MarcosQOliva/SongBeam/modulesTAD/GJM1555C1H470JB01D/GJM1555C1H470JB01D.step

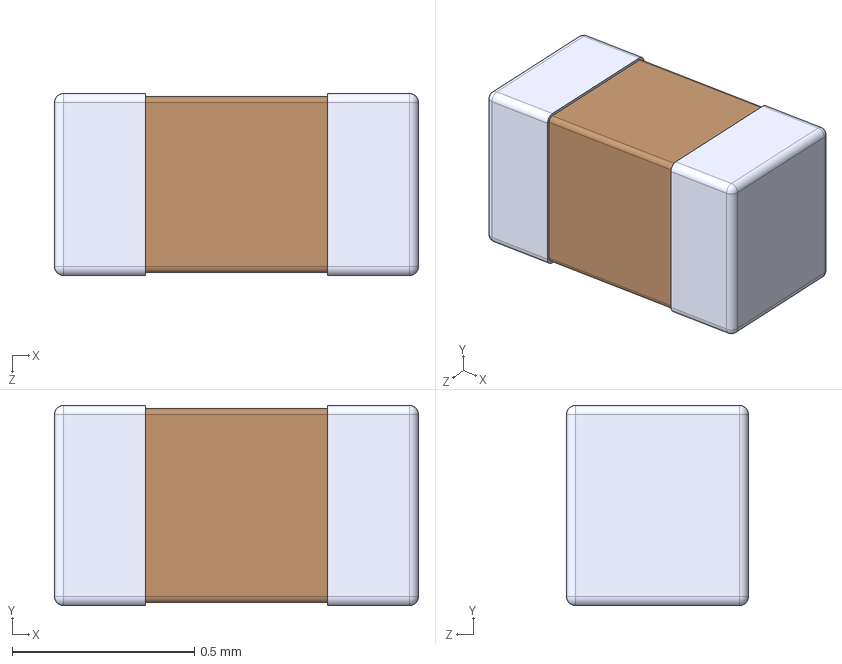
[picture p1: CAD file, 2026-02-26]
modulesTAD/GJM1555C1H470JB01D/GJM1555C1H470JB01D.step
1.00 x 0.55 x 0.5 mm
