MarcosQOliva/SongBeam/modulesTAD/LIB_ADAU7112ACBZR7/ADAU7112ACBZR7.stp

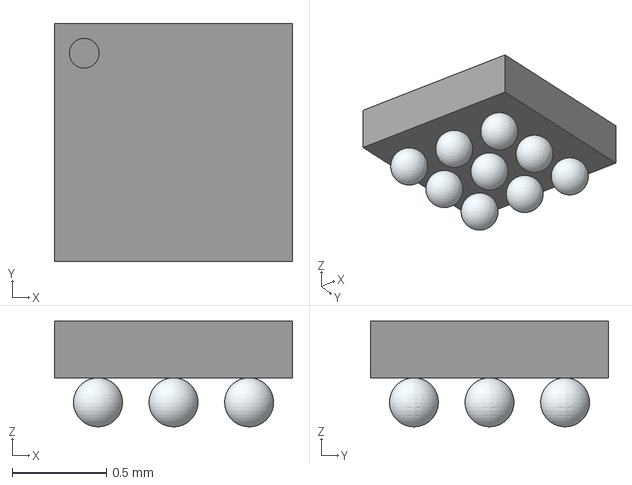
[picture p2: CAD file, 2026-11-06]
modulesTAD/LIB_ADAU7112ACBZR7/ADAU7112ACBZR7.stp
1.26 x 1.26 x 0.56 mm
