MarcosQOliva/SongBeam/modulesTAD/LIB_DTC143ZEBTL/DTC143ZEBTL.stp

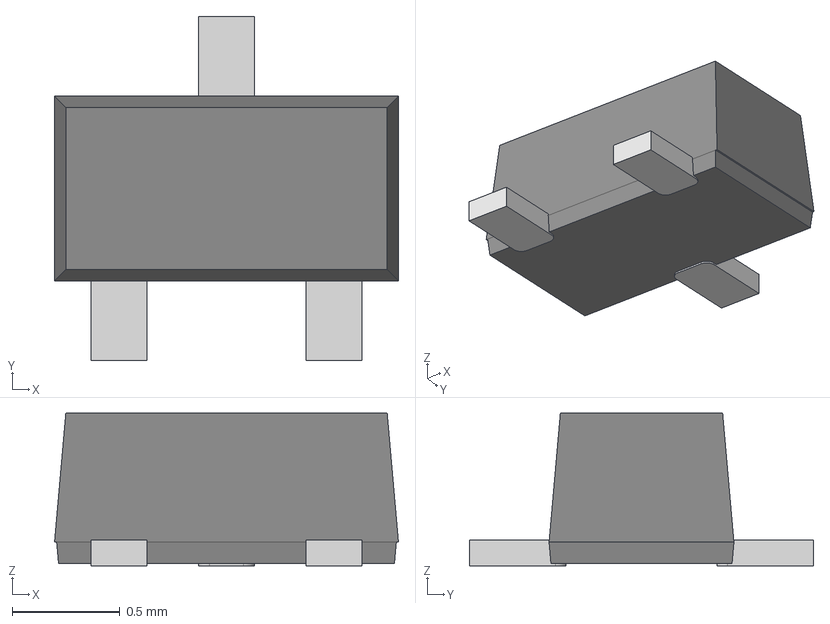
[picture p3: CAD file, 2026-03-02]
modulesTAD/LIB_DTC143ZEBTL/DTC143ZEBTL.stp
1.60 x 1.60 x 0.71 mm
EMT3F-prt0
EMT3F-prt1
EMT3F-prt2
EMT3F-prt3
