MarcosQOliva/SongBeam/modulesTAD/LIB_L86-M33/L86-M33.stp

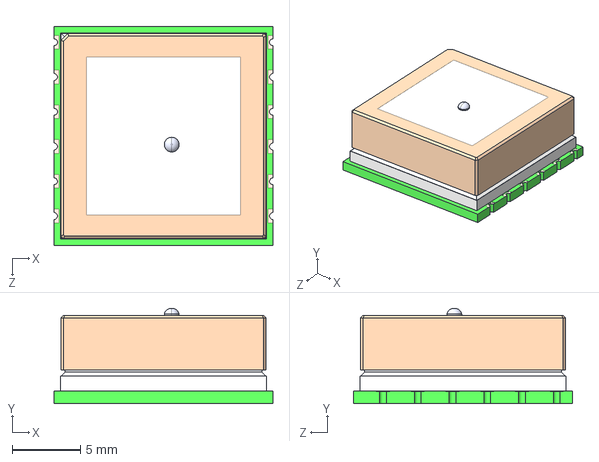
[picture p4: CAD file, 2026-03-02]
modulesTAD/LIB_L86-M33/L86-M33.stp
16.0 x 6.95 x 16.0 mm
