MarcosQOliva/SongBeam/modulesTAD/LIB_MBRX120LF-TP/MBRX120LF-TP.stp

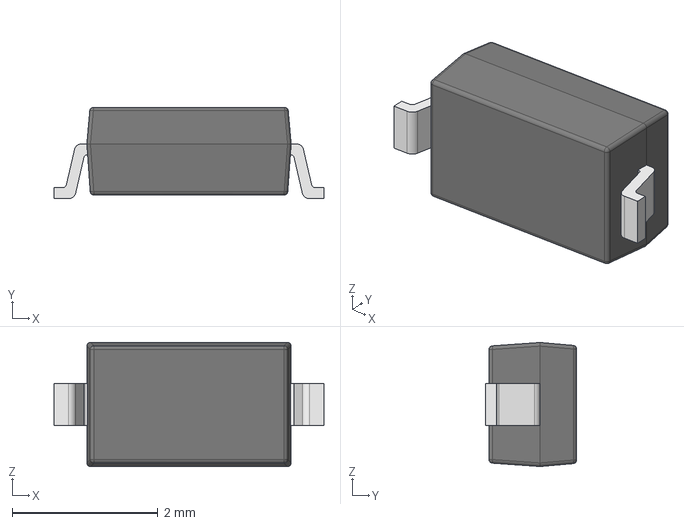
[picture p5: CAD file, 2026-03-02]
modulesTAD/LIB_MBRX120LF-TP/MBRX120LF-TP.stp
3.70 x 1.25 x 1.70 mm
��1
��2
