MarcosQOliva/SongBeam/modulesTAD/LIB_MINISMDC050F-2/MINISMDC050F-2.stp

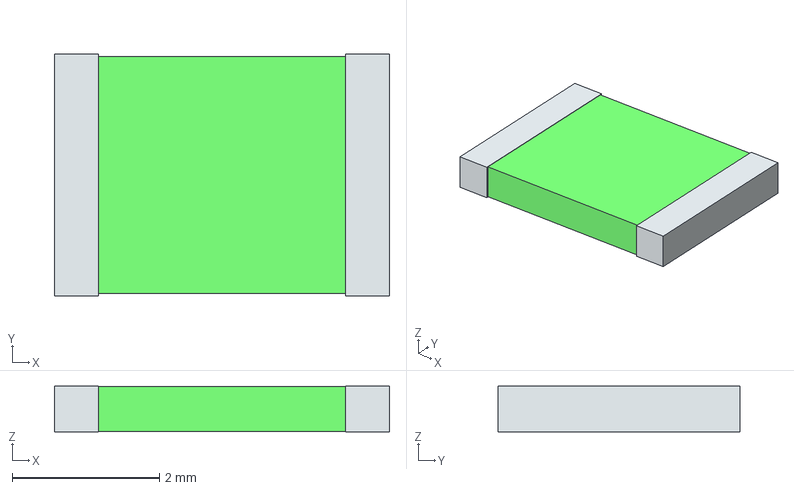
[picture p6: CAD file, 2026-03-02]
modulesTAD/LIB_MINISMDC050F-2/MINISMDC050F-2.stp
4.55 x 3.29 x 0.62 mm
term1
term2
