MarcosQOliva/SongBeam/modulesTAD/LIB_SFH_2716_A01/SFH2716A01.stp

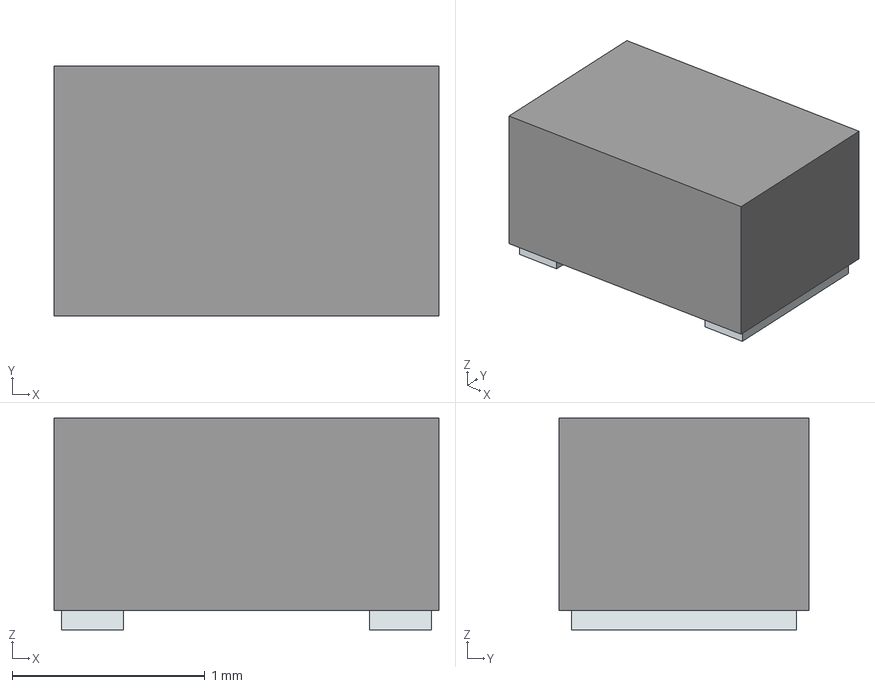
[picture p7: CAD file, 2026-03-02]
modulesTAD/LIB_SFH_2716_A01/SFH2716A01.stp
2.00 x 1.30 x 1.10 mm
Pins
