MarcosQOliva/SongBeam/modulesTAD/LIB_SLW-12689-4A-N-D/SLW-12689-4A-N-D.stp

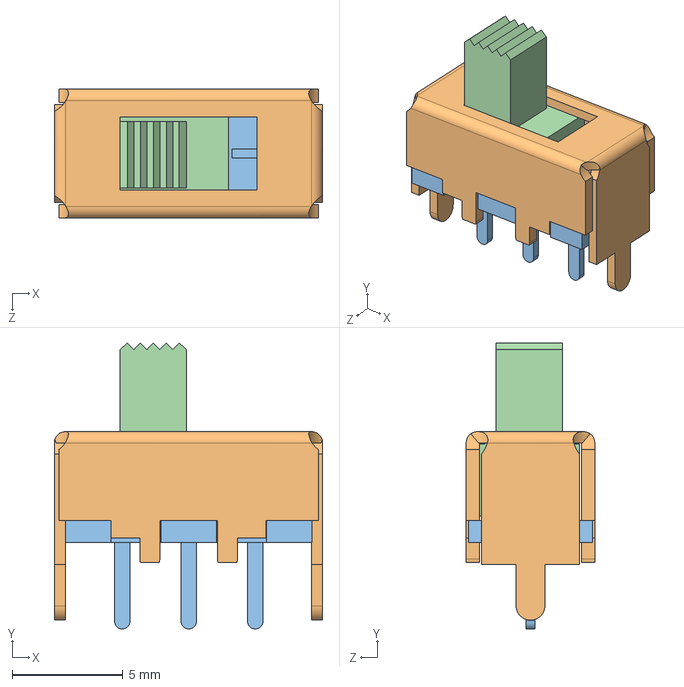
[picture p8: CAD file, 2026-03-02]
modulesTAD/LIB_SLW-12689-4A-N-D/SLW-12689-4A-N-D.stp
12.1 x 12.9 x 5.80 mm
