MarcosQOliva/SongBeam/modulesTAD/LIB_TXU0304RUTR/TXU0304RUTR.stp

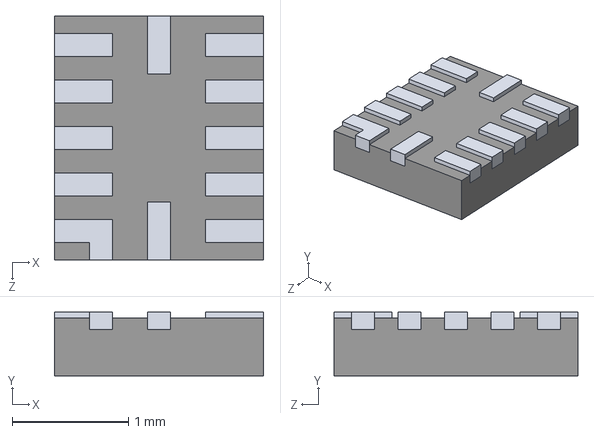
[picture p9: CAD file, 2026-11-06]
modulesTAD/LIB_TXU0304RUTR/TXU0304RUTR.stp
1.80 x 0.55 x 2.10 mm
