MarcosQOliva/SongBeam/modulesTAD/ul_PCMD3180IRTWR/PCMD3180IRTWT.stp

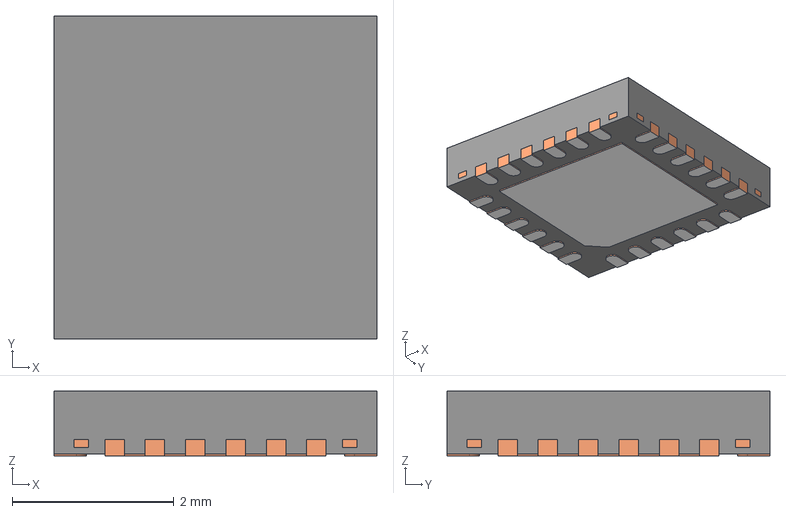
[picture p10: CAD file, 2026-03-02]
modulesTAD/ul_PCMD3180IRTWR/PCMD3180IRTWT.stp
4.00 x 4.00 x 0.8 mm
BODY-QFN
FRAME-RTW0024H
PIN1-ID
