MarcosQOliva/SongBeam/modulesTAD/ul_TPL5111DDCR/TPL5111DDCR.stp

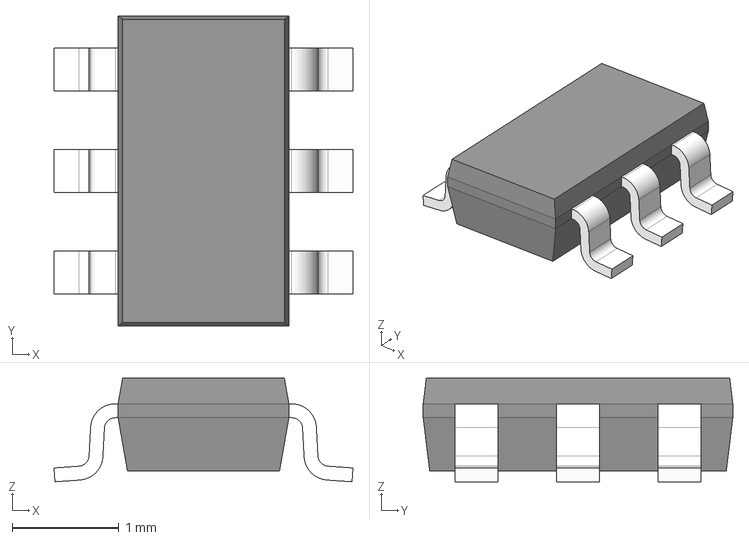
[picture p11: CAD file, 2026-03-02]
modulesTAD/ul_TPL5111DDCR/TPL5111DDCR.stp
2.80 x 2.90 x 0.97 mm
BODY-SOT
LEAD-SOT x 6
