MarcosQOliva/SongBeam/modulesTAD/CONN_73251-1150_MOL/73251-1150.stp

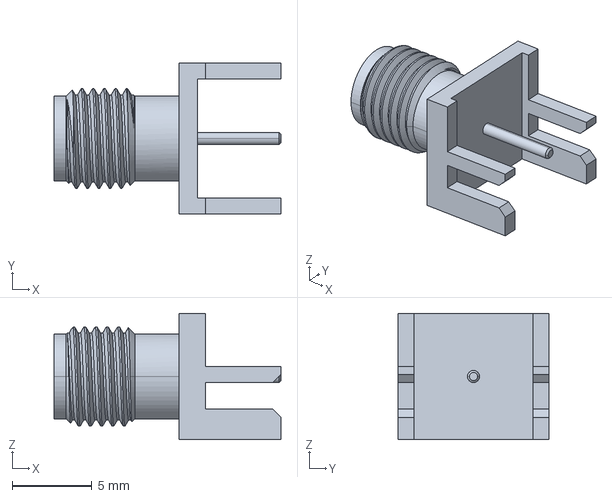
[picture p12: CAD file, 2026-03-02]
modulesTAD/CONN_73251-1150_MOL/73251-1150.stp
14.3 x 9.53 x 7.92 mm
