MarcosQOliva/SongBeam/modulesTAD/LIB_10118192-0002LF/10118192-0002LF.stp

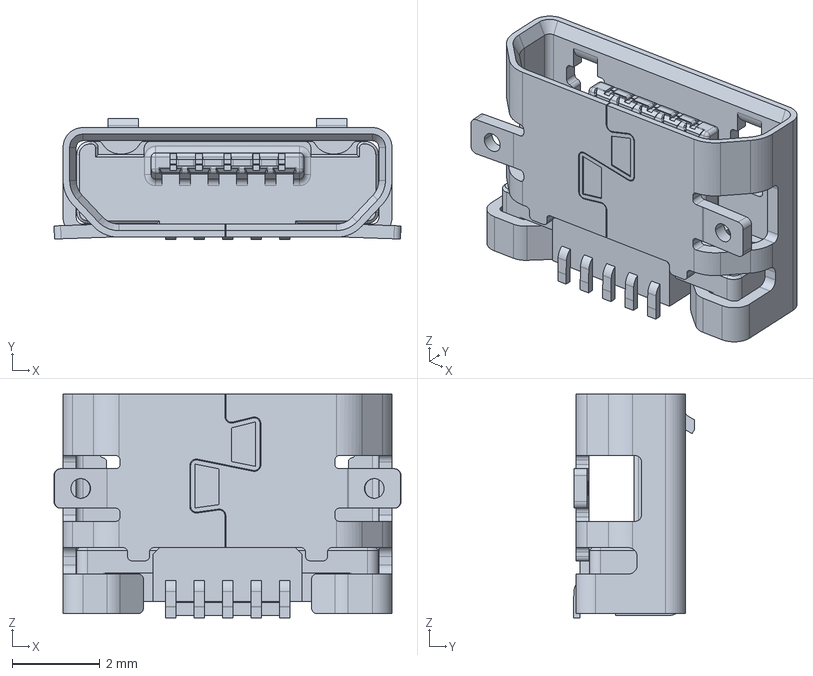
[picture p13: CAD file, 2026-03-02]
modulesTAD/LIB_10118192-0002LF/10118192-0002LF.stp
7.91 x 2.77 x 5.10 mm
