MarcosQOliva/SongBeam/modulesTAD/LIB_79523211/79523211.stp

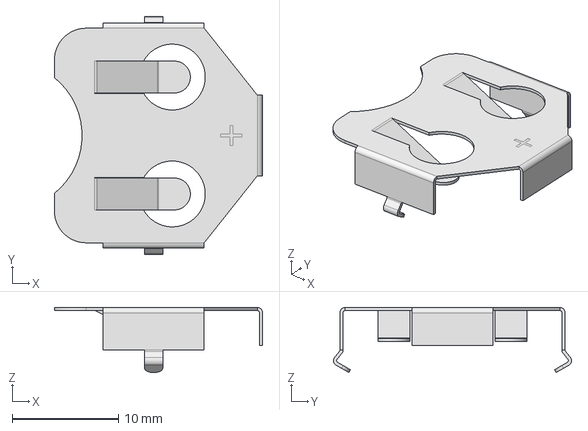
[picture p14: CAD file, 2026-03-02]
modulesTAD/LIB_79523211/79523211.stp
19.6 x 22.4 x 6.12 mm
