MarcosQOliva/SongBeam/modulesTAD/LIB_DFE201612E-2R2M=P2/DFE201612E-2R2M=P2.stp

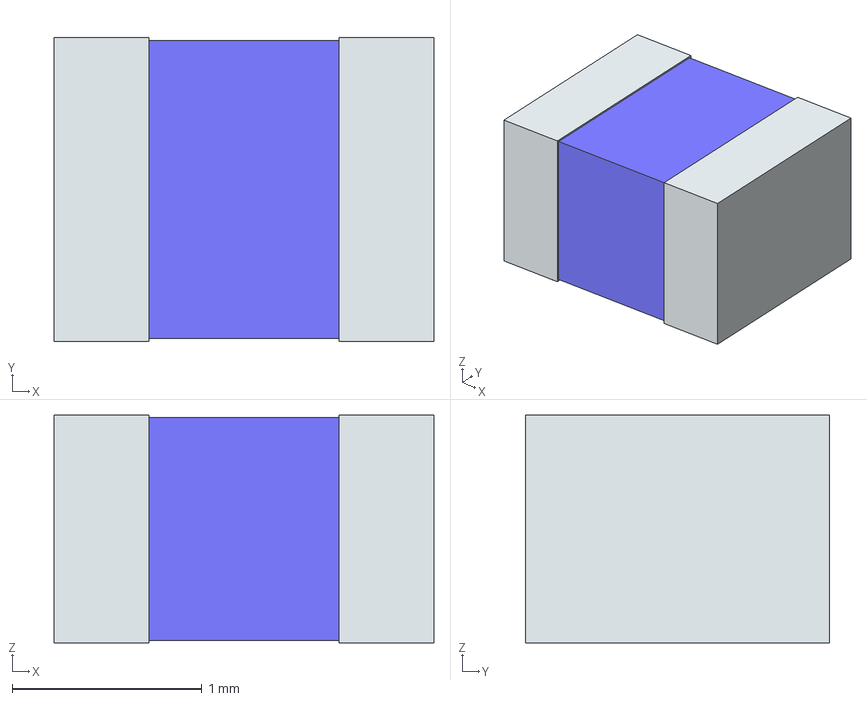
[picture p15: CAD file, 2026-03-02]
modulesTAD/LIB_DFE201612E-2R2M=P2/DFE201612E-2R2M=P2.stp
2.00 x 1.60 x 1.20 mm
term1
term2
