MarcosQOliva/SongBeam/Hardware/MIcBoard_1/plots/MIcBoard_1__Assembly.pdf

AB

AB

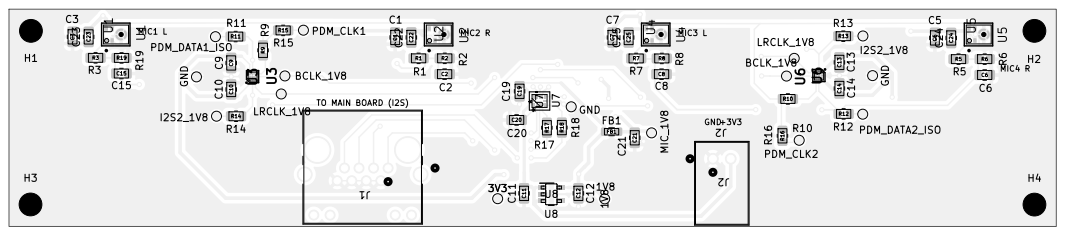
[picture p16: page 1]

Board2Pdf: Black And White TOP - Page 1/2

Marcos Q. Oliva, Rob Lachlan
Royal Holloway
Sheet: Black And White TOP
File: MIcBoard_1.kicad_pcb
Title: SongBeam_micboard
KiCad E.D.A. 10.0.7

AB

AB

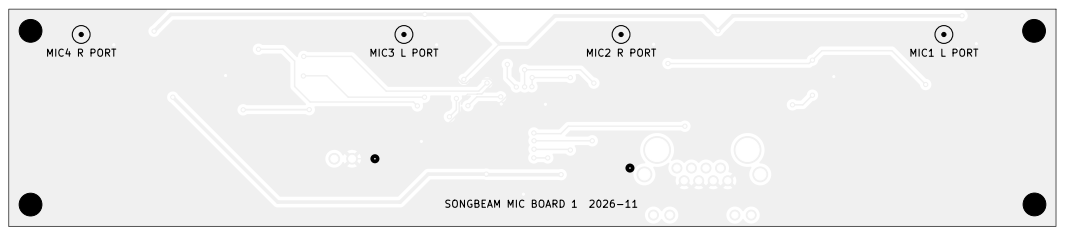
[picture p17: page 2]
MIC2 R PORT; MIC1 L PORT SONGBEAM MIC BOARD 1 2026-11 MIC4 R PORT; MIC3 L PORT 1; D Date: 2026-11-11; Size: A4; Rev: 1.o

Board2Pdf: Black And White BOT - Page 2/2

Marcos Q. Oliva, Rob Lachlan
Royal Holloway
Sheet: Black And White BOT
File: MIcBoard_1.kicad_pcb
Title: SongBeam_micboard
KiCad E.D.A. 10.0.7
