MarcosQOliva/SongBeam/(list of files, drawings)

Other design files:
Hardware/MIcBoard_1/temp-freerouting.dsn
