MarcosQOliva/SongBeam/Hardware/MIcBoard_1/MIcBoard_1.kicad_pcb

## KiCad design Hardware/MIcBoard_1/MIcBoard_1.kicad_pcb (2026-11-11)

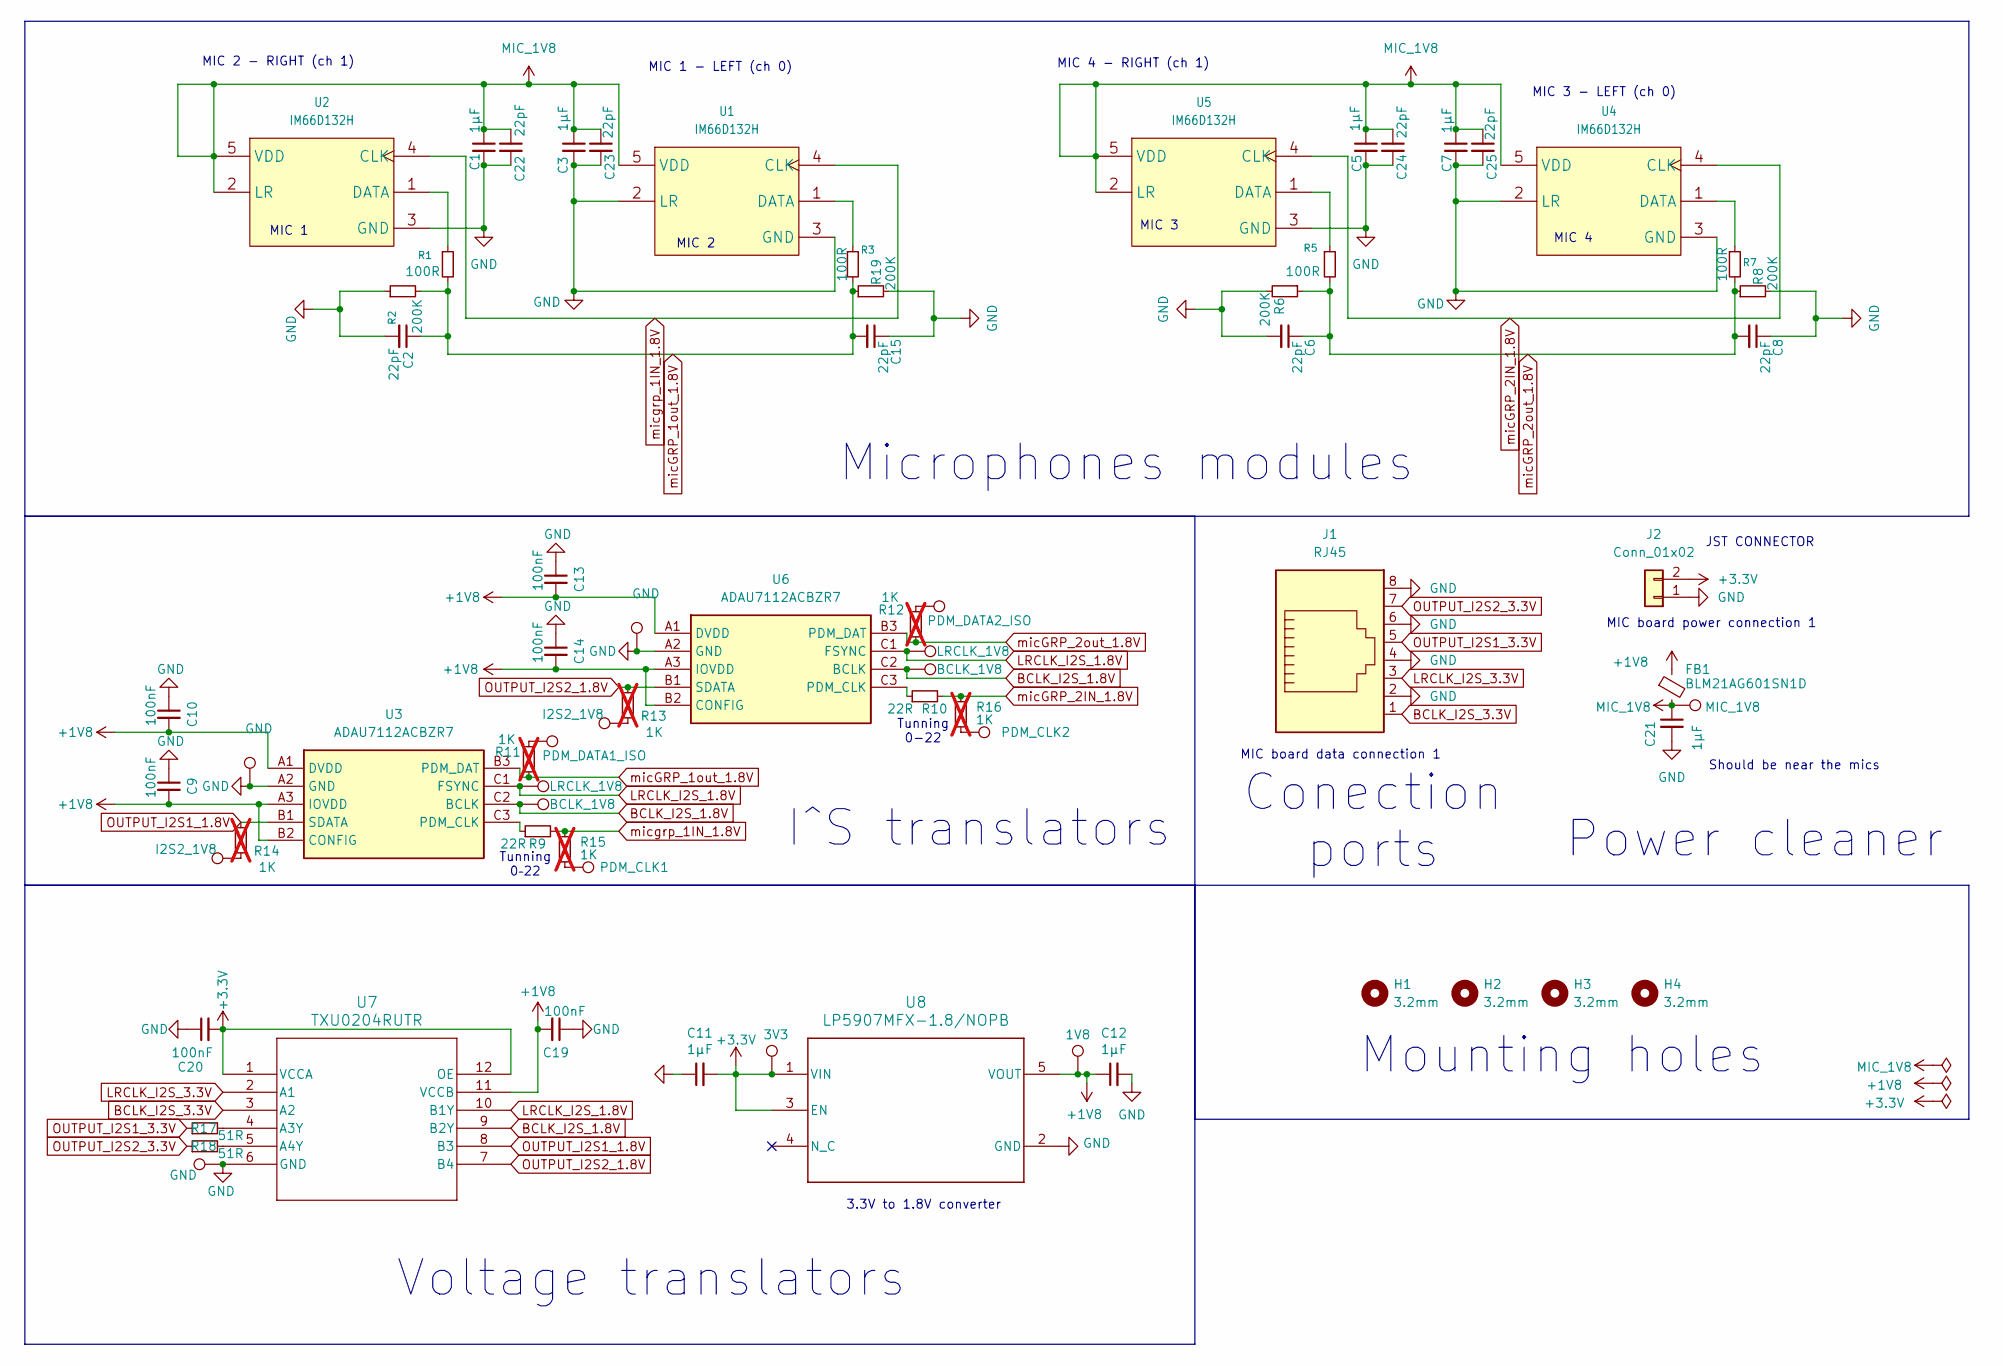
[picture p18: schematic MIcBoard_1.kicad_sch, SongBeam MicB]

Parts:
1V8, 3V3: TestPoint; TestPoint_Pad_D1.0mm
C1, C3, C5, C7, C11, C12, C21: 1µF; C_0805_2012Metric; Voltage 25V
C2, C6, C8, C15, C22, C23, C24, C25: 22pF; C_0805_2012Metric; Voltage 50V
C9, C10, C13, C14, C19, C20: 100nF; C_0805_2012Metric; Voltage 25V
FB1: BLM21AG601SN1D; L_0805_2012Metric
H1, H2, H3, H4: 3.2mm; MountingHole_3.2mm_M3_ISO14580
J1: RJ45; RJHSE5380_AMP
J2: Conn_01x02; CONN_S2B-XH-A_JST
R1, R3, R5, R7: 100R; R_0805_2012Metric
R2, R6, R8, R19: 200K; R_0805_2012Metric
R9, R10: 22R; R_0805_2012Metric
R11, R12, R13, R14, R15, R16: 1K; R_0805_2012Metric; not fitted
R17, R18: 51R; R_0805_2012Metric
TP3: PDM_DATA1_ISO; TestPoint_Pad_D1.0mm
TP4: PDM_DATA2_ISO; TestPoint_Pad_D1.0mm
TP5: MIC_1V8; TestPoint_Pad_D1.0mm
TP6, TP7, TP15: GND; TestPoint_Pad_D1.0mm
TP12, TP19: BCLK_1V8; TestPoint_Pad_D1.0mm
TP13, TP18: LRCLK_1V8; TestPoint_Pad_D1.0mm
TP16: PDM_CLK1; TestPoint_Pad_D1.0mm
TP17, TP21: I2S2_1V8; TestPoint_Pad_D1.0mm
TP20: PDM_CLK2; TestPoint_Pad_D1.0mm
U1, U2, U4, U5: IM66D132H; IFX-PG-TLGA-5N-9-V
U3, U6: ADAU7112ACBZR7; BGA9C40P3X3_126X126X56; Manufacturer_Part_Number ADAU7112ACBZR7; Mouser Part Number 584-AU7112ACBZR7
U7: TXU0204RUTR; QFN_04RUTR_TEX
U8: LP5907MFX-1.8/NOPB; DBV0005A_N

Connections:
+1V8: 1V8.1 (1_1), C9.2, C10.2, C12.1, C13.2, C14.2, C19.2, FB1.1, U3.A1 (DVDD), U3.A3 (IOVDD), U3.B2 (CONFIG), U6.A1 (DVDD), U6.A3 (IOVDD), U6.B2 (CONFIG), U7.11 (VCCB), U8.5 (VOUT)
+3.3V: 3V3.1 (1_1), C11.2, C20.2, J2.2, U7.1 (VCCA), U7.12 (OE), U8.1 (VIN), U8.3 (EN)
BCLK_I2S_1.8V: TP12.1 (1_1), TP19.1 (1_1), U3.C2 (BCLK), U6.C2 (BCLK), U7.9 (B2Y)
BCLK_I2S_3.3V: J1.1, U7.3 (A2)
GND: C1.2, C2.2, C3.2, C5.2, C6.2, C7.2, C8.1, C9.1, C10.1, C11.1, C12.2, C13.1, C14.1, C15.1, C19.1, C20.1, C21.2, C22.2, C23.2, C24.2, C25.2, J1.2, J1.4, J1.6, J1.8, J2.1, R2.1, R6.2, R8.2, R19.2, TP6.1 (1_1), TP7.1 (1_1), TP15.1 (1_1), U1.2 (LR), U1.3 (GND), U2.3 (GND), U3.A2 (GND), U4.2 (LR), U4.3 (GND), U5.3 (GND), U6.A2 (GND), U7.6 (GND), U8.2 (GND)
LRCLK_I2S_1.8V: TP13.1 (1_1), TP18.1 (1_1), U3.C1 (FSYNC), U6.C1 (FSYNC), U7.10 (B1Y)
LRCLK_I2S_3.3V: J1.3, U7.2 (A1)
MIC_1V8: C1.1, C3.1, C5.1, C7.1, C21.1, C22.1, C23.1, C24.1, C25.1, FB1.2, TP5.1 (1_1), U1.5 (VDD), U2.2 (LR), U2.5 (VDD), U4.5 (VDD), U5.2 (LR), U5.5 (VDD)
unnamed: R11.2, TP3.1 (1_1)
unnamed: R12.2, TP4.1 (1_1)
unnamed: R13.1, TP17.1 (1_1)
unnamed: R14.1, TP21.1 (1_1)
unnamed: R15.2, TP16.1 (1_1)
unnamed: R16.2, TP20.1 (1_1)
unnamed: R3.1, U1.1 (DATA)
unnamed: R1.1, U2.1 (DATA)
unnamed: R9.1, U3.C3 (PDM_CLK)
unnamed: R7.1, U4.1 (DATA)
unnamed: R5.1, U5.1 (DATA)
unnamed: R10.1, U6.C3 (PDM_CLK)
unnamed: R17.2, U7.4 (A3Y)
unnamed: R18.2, U7.5 (A4Y)
OUTPUT_I2S1_1.8V: R14.2, U3.B1 (SDATA), U7.8 (B3)
OUTPUT_I2S1_3.3V: J1.5, R17.1
OUTPUT_I2S2_1.8V: R13.2, U6.B1 (SDATA), U7.7 (B4)
OUTPUT_I2S2_3.3V: J1.7, R18.1
micGRP_1out_1.8V: C2.1, C15.2, R1.2, R2.2, R3.2, R11.1, R19.1, U3.B3 (PDM_DAT)
micGRP_2IN_1.8V: R10.2, R16.1, U4.4 (CLK), U5.4 (CLK)
micGRP_2out_1.8V: C6.1, C8.2, R5.2, R6.1, R7.2, R8.1, R12.1, U6.B3 (PDM_DAT)
micgrp_1IN_1.8V: R9.2, R15.1, U1.4 (CLK), U2.4 (CLK)

Notes on the sheet:
Microphones modules
MIC 1 - LEFT (ch 0)
Should be near the mics
Voltage translators
Power cleaner
JST CONNECTOR
MIC 4 - RIGHT (ch 1)
MIC 1
MIC 2
Tunning 0-22
Tunning 0–22
MIC 3
3.3V to 1.8V converter
MIC 4
Conection ports
Mounting holes
MIC 2 - RIGHT (ch 1)
MIC board data connection 1
I^S translators
MIC board power connection 1
MIC 3 - LEFT (ch 0)

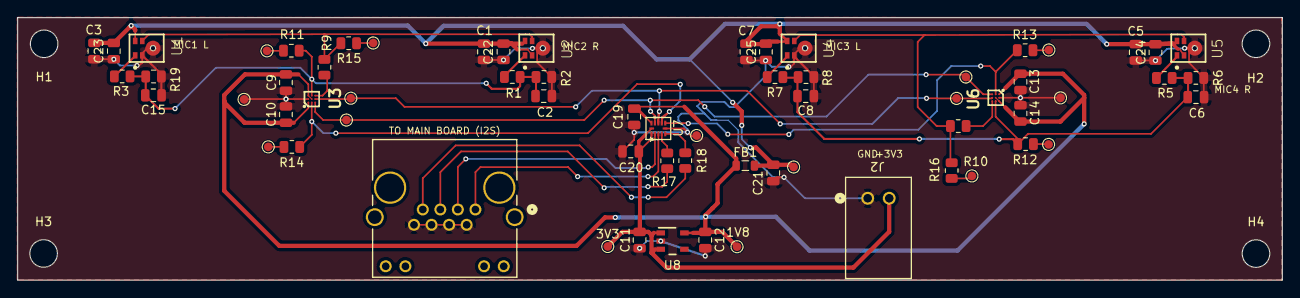
[picture p19: board MIcBoard_1.kicad_pcb from above]

Board: 2 copper layers, 147.0 x 30.5 mm, 70 parts (0 on the bottom side), 30 nets.
