MarcosQOliva/SongBeam/Hardware/Daughterboard_A/daugtherboard_1.2.kicad_pcb

## KiCad design Hardware/Daughterboard_A/daugtherboard_1.2.kicad_pcb (2026-04-28)

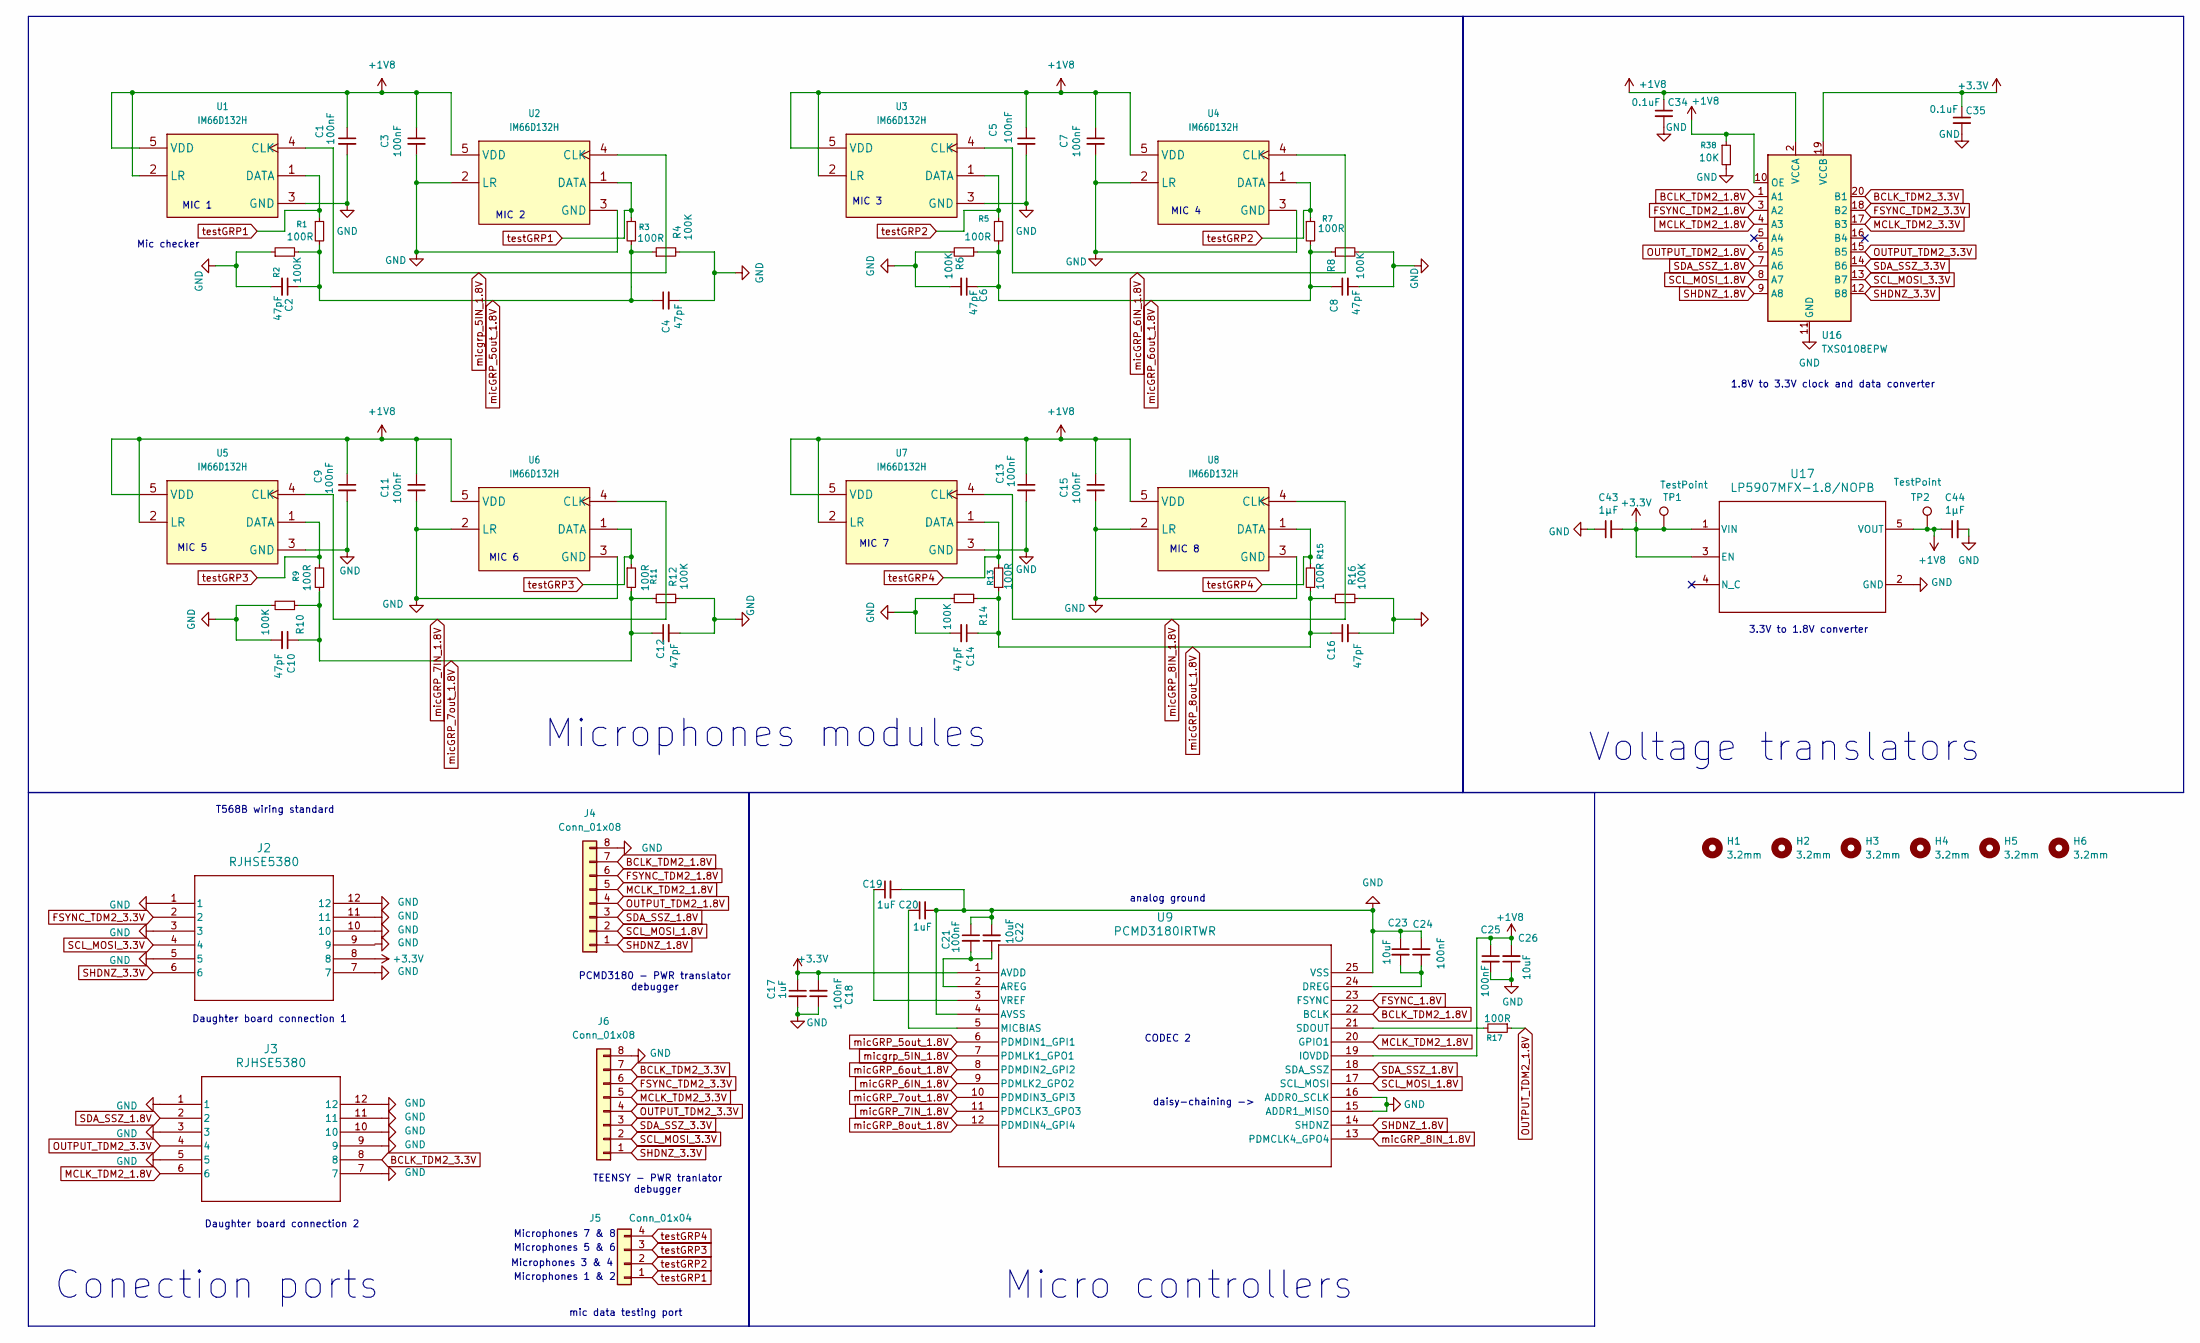
[picture p20: schematic daugtherboard_1.2.kicad_sch, Song beam DaughterBoard A]

Parts:
C1, C3, C5, C7, C9, C11, C13, C15, C18, C21, C24, C25: 100nF; C_0805_2012Metric
C2, C4, C6, C8, C10, C12, C14, C16: 47pF; C_0805_2012Metric
C17, C19, C20: 1uF; C_0805_2012Metric
C22, C23, C26: 10uF; C_0805_2012Metric
C34, C35: 0.1uF; C_0805_2012Metric
C43, C44: 1µF; C_0805_2012Metric
H1, H2, H3, H4, H5, H6: 3.2mm; MountingHole_3.2mm_M3_ISO14580
J2, J3: RJHSE5380; RJHSE5380_AMP
J4, J6: Conn_01x08; PinHeader_1x08_P2.00mm_Vertical
J5: Conn_01x04; PinHeader_1x04_P2.00mm_Vertical
R1, R3, R5, R7, R9, R11, R13, R15, R17: 100R; R_0805_2012Metric
R2, R4, R6, R8, R10, R12, R14, R16: 100K; R_0805_2012Metric
R38: 10K; R_0805_2012Metric
TP1, TP2: TestPoint; TestPoint_Pad_D1.0mm
U1, U2, U3, U4, U5, U6, U7, U8: IM66D132H; IFX-PG-TLGA-5N-9-V
U9: PCMD3180IRTWR
U16: TXS0108EPW; TSSOP-20_4.4x6.5mm_P0.65mm
U17: LP5907MFX-1.8/NOPB; DBV0005A_N

Connections:
+1V8: C1.1, C3.1, C5.1, C7.1, C9.1, C11.1, C13.1, C15.1, C25.1, C26.2, C34.1, C44.1, R38.1, TP2.1, U1.2 (LR), U1.5 (VDD), U2.5 (VDD), U3.2 (LR), U3.5 (VDD), U4.5 (VDD), U5.2 (LR), U5.5 (VDD), U6.5 (VDD), U7.2 (LR), U7.5 (VDD), U8.5 (VDD), U9.19 (IOVDD), U16.2 (VCCA), U16.10 (OE), U17.5 (VOUT)
+3.3V: C17.1, C18.2, C35.1, C43.2, J2.8, TP1.1, U9.1 (AVDD), U16.19 (VCCB), U17.1 (VIN), U17.3 (EN)
BCLK_TDM2_1.8V: J4.7, U9.22 (BCLK), U16.1 (A1)
BCLK_TDM2_3.3V: J3.8, J6.7, U16.20 (B1)
FSYNC_1.8V: U9.23 (FSYNC)
FSYNC_TDM2_1.8V: J4.6, U16.3 (A2)
FSYNC_TDM2_3.3V: J2.2, J6.6, U16.18 (B2)
GND: C1.2, C2.2, C3.2, C4.2, C5.2, C6.2, C7.2, C8.2, C9.2, C10.2, C11.2, C12.2, C13.2, C14.2, C15.2, C16.2, C17.2, C18.1, C19.2, C20.2, C21.1, C22.2, C23.1, C24.2, C25.2, C26.1, C34.2, C35.2, C43.1, C44.2, J2.1, J2.3, J2.5, J2.7, J2.10, J2.11, J2.12, J3.1, J3.3, J3.5, J3.7, J3.9, J3.10, J3.11, J3.12, J4.8, J6.8, R2.1, R4.2, R6.2, R8.2, R10.2, R12.2, R14.2, R16.2, R38.2, U1.3 (GND), U2.2 (LR), U2.3 (GND), U3.3 (GND), U4.2 (LR), U4.3 (GND), U5.3 (GND), U6.2 (LR), U6.3 (GND), U7.3 (GND), U8.2 (LR), U8.3 (GND), U9.4 (AVSS), U9.15 (ADDR1_MISO), U9.16 (ADDR0_SCLK), U9.25 (VSS), U16.11 (GND), U17.2 (GND)
MCLK_TDM2_1.8V: J3.6, J4.5, U9.20 (GPIO1), U16.4 (A3)
MCLK_TDM2_3.3V: J6.5, U16.17 (B3)
unnamed: C21.2, C22.1, U9.2 (AREG)
unnamed: C23.2, C24.1, U9.24 (DREG)
unnamed: C20.1, U9.5 (MICBIAS)
unnamed: R17.2, U9.21 (SDOUT)
unnamed: C19.1, U9.3 (VREF)
OUTPUT_TDM2_1.8V: J4.4, R17.1, U16.6 (A5)
OUTPUT_TDM2_3.3V: J3.4, J6.4, U16.15 (B5)
SCL_MOSI_1.8V: J4.2, U9.17 (SCL_MOSI), U16.8 (A7)
SCL_MOSI_3.3V: J2.4, J6.2, U16.13 (B7)
SDA_SSZ_1.8V: J3.2, J4.3, U9.18 (SDA_SSZ), U16.7 (A6)
SDA_SSZ_3.3V: J6.3, U16.14 (B6)
SHDNZ_1.8V: J4.1, U9.14 (SHDNZ), U16.9 (A8)
SHDNZ_3.3V: J2.6, J6.1, U16.12 (B8)
micGRP_5out_1.8V: C2.1, C4.1, R1.2, R2.2, R3.2, R4.1, U9.6 (PDMDIN1_GPI1)
micGRP_6IN_1.8V: U3.4 (CLK), U4.4 (CLK), U9.9 (PDMLK2_GPO2)
micGRP_6out_1.8V: C6.1, C8.1, R5.2, R6.1, R7.2, R8.1, U9.8 (PDMDIN2_GPI2)
micGRP_7IN_1.8V: U5.4 (CLK), U6.4 (CLK), U9.11 (PDMCLK3_GPO3)
micGRP_7out_1.8V: C10.1, C12.1, R9.2, R10.1, R11.2, R12.1, U9.10 (PDMDIN3_GPI3)
micGRP_8IN_1.8V: U7.4 (CLK), U8.4 (CLK), U9.13 (PDMCLK4_GPO4)
micGRP_8out_1.8V: C14.1, C16.1, R13.1, R14.1, R15.1, R16.1, U9.12 (PDMDIN4_GPI4)
micgrp_5IN_1.8V: U1.4 (CLK), U2.4 (CLK), U9.7 (PDMLK1_GPO1)
testGRP1: J5.1, R1.1, R3.1, U1.1 (DATA), U2.1 (DATA)
testGRP2: J5.2, R5.1, R7.1, U3.1 (DATA), U4.1 (DATA)
testGRP3: J5.3, R9.1, R11.1, U5.1 (DATA), U6.1 (DATA)
testGRP4: J5.4, R13.2, R15.2, U7.1 (DATA), U8.1 (DATA)

Notes on the sheet:
Mic checker
MIC 7
TEENSY - PWR tranlator debugger
MIC 1
3.3V to 1.8V converter
Microphones 3 & 4
analog ground
MIC 5
Voltage translators
MIC 8
Daughter board connection 1
CODEC 2
PCMD3180 - PWR translator debugger
Microphones modules
MIC 6
Microphones 7 & 8
1.8V to 3.3V clock and data converter
Daughter board connection 2
Micro controllers
Microphones 1 & 2
daisy-chaining ->
T568B wiring standard
Microphones 5 & 6
MIC 2
MIC 4
Conection ports
MIC 3
mic data testing port

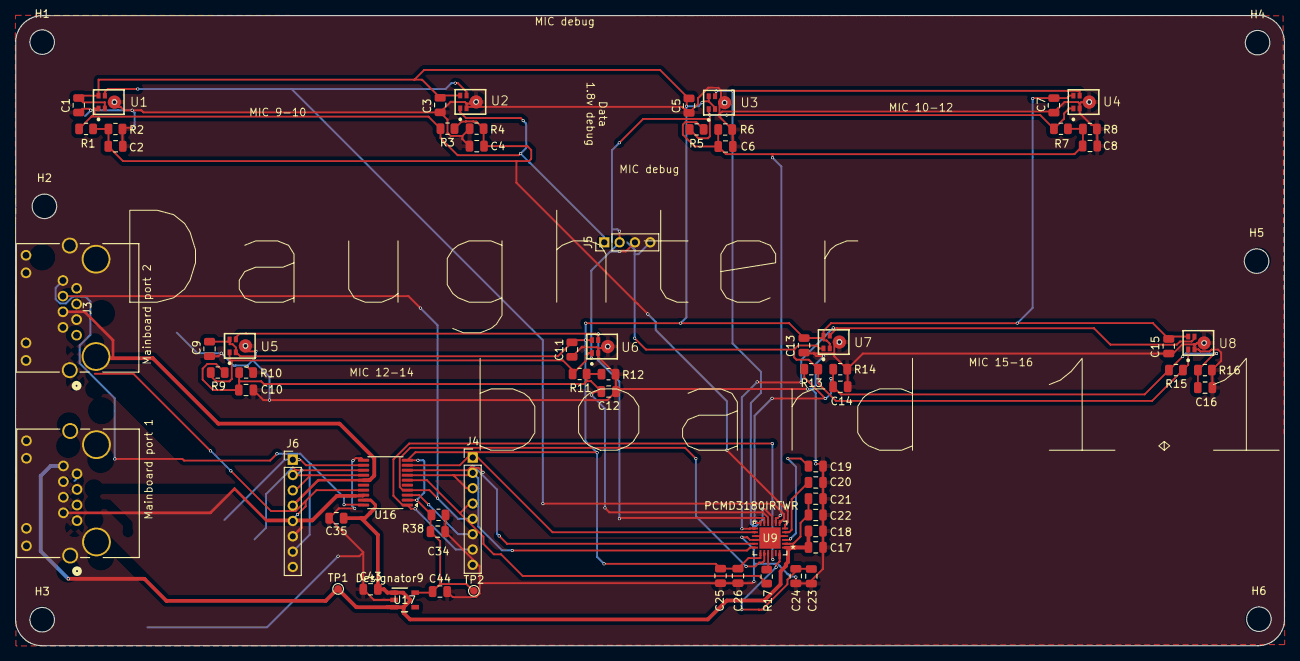
[picture p21: board daugtherboard_1.2.kicad_pcb from above]

Board: 2 copper layers, 165.6 x 82.3 mm, 72 parts (0 on the bottom side), 34 nets.
