MarcosQOliva/SongBeam/Hardware/SongBeam4.0/SongBeam4.1.kicad_pcb

## KiCad design Hardware/SongBeam4.0/SongBeam4.1.kicad_pcb (2026-03-04)

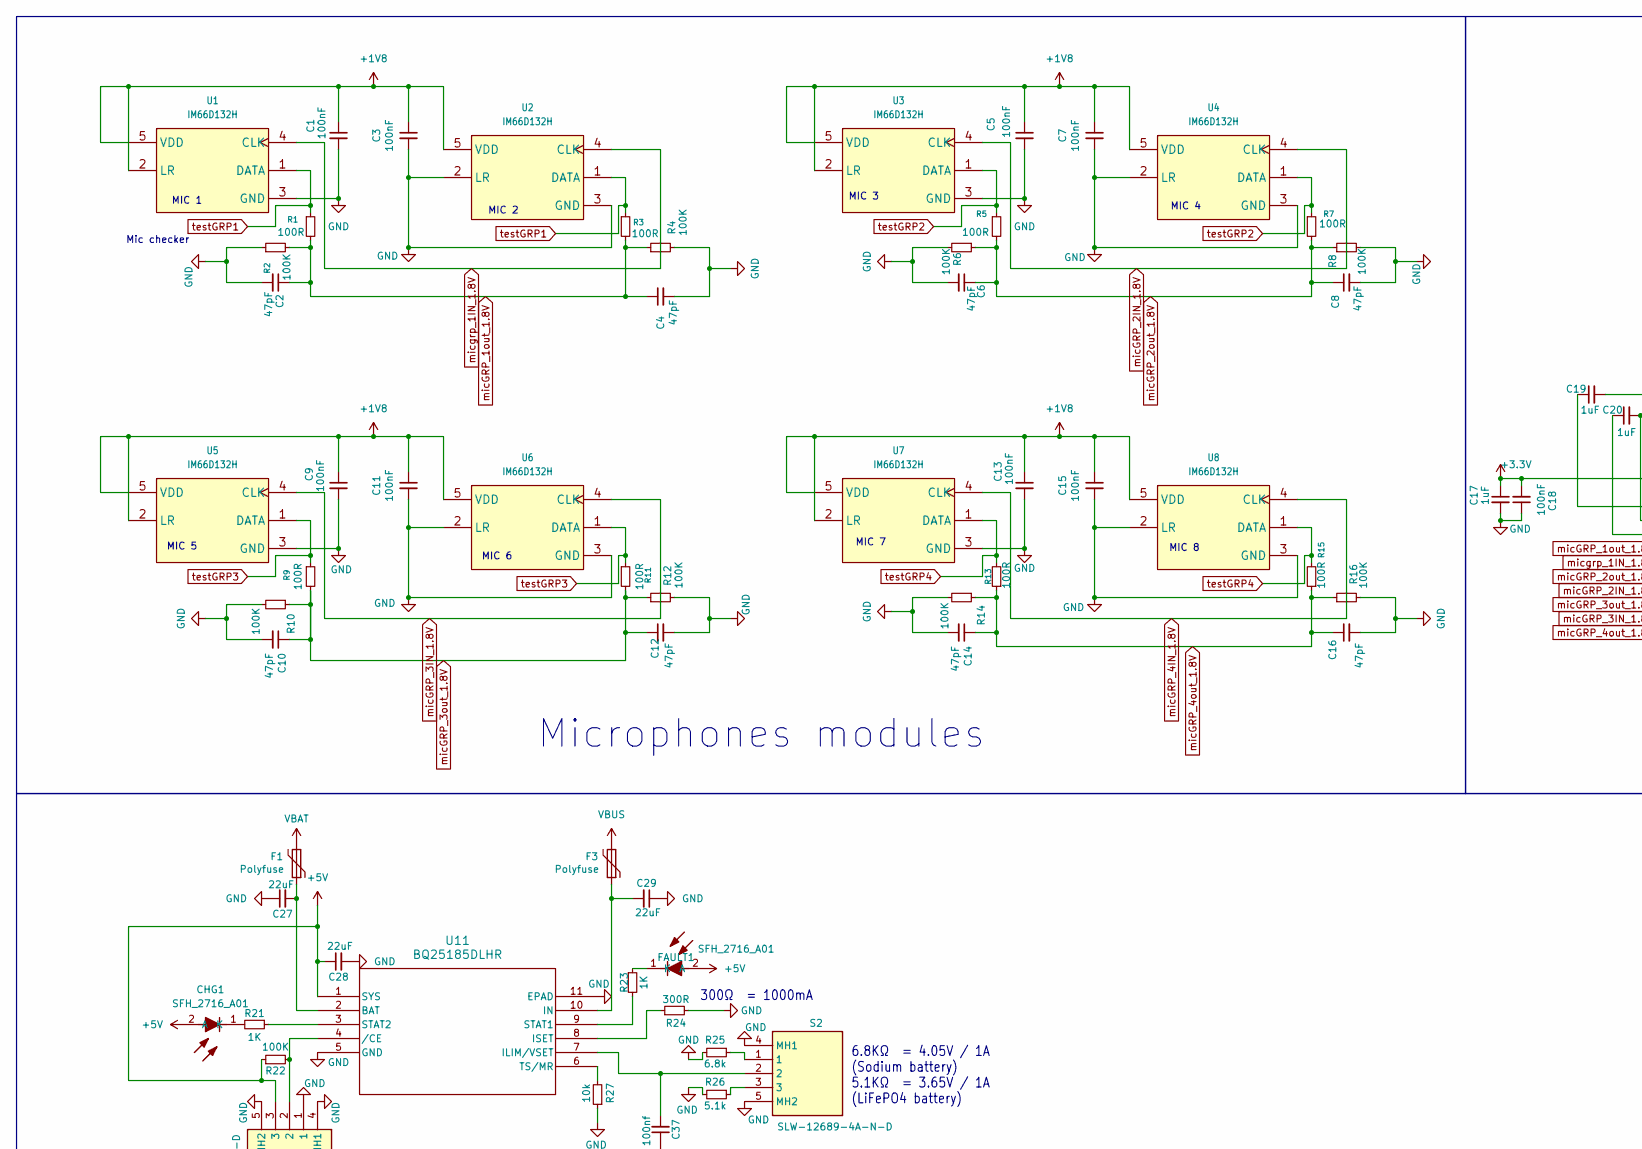
[picture p22: schematic SongBeam4.1.kicad_sch, Song Beam, part in row 1, column 1]

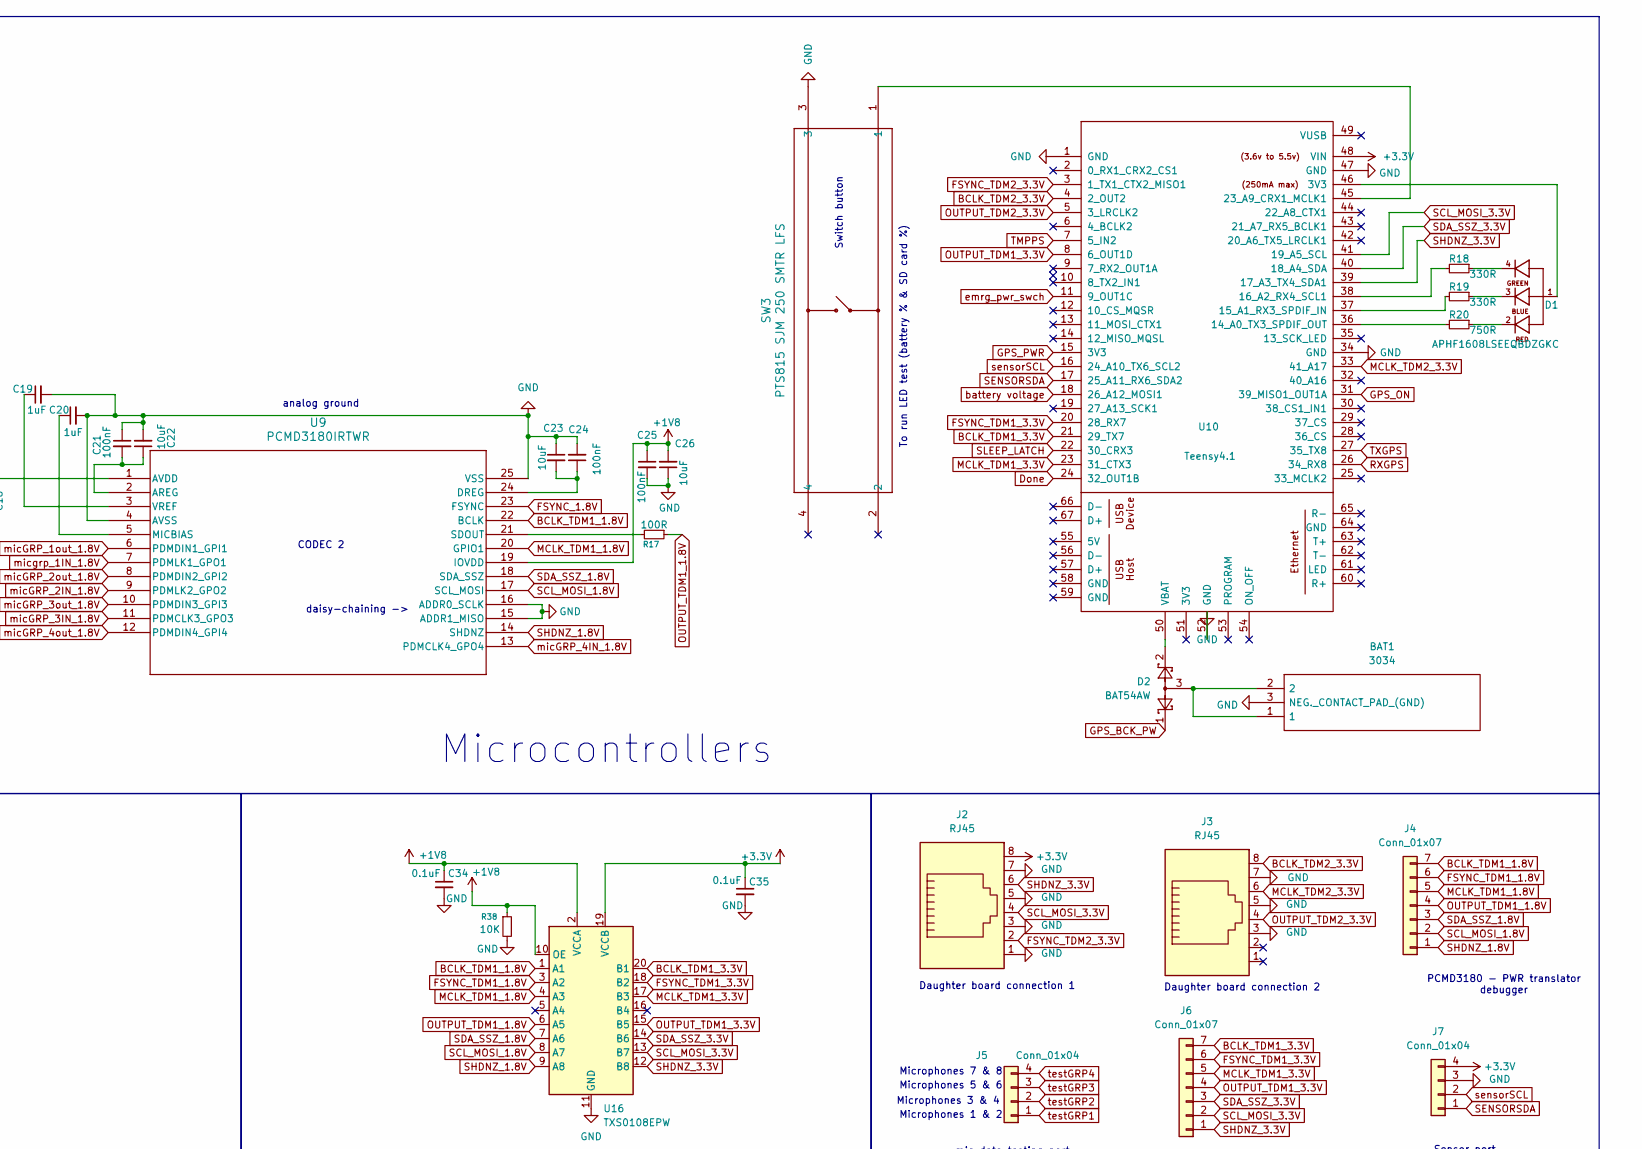
[picture p23: schematic SongBeam4.1.kicad_sch, Song Beam, part in row 1, column 2]

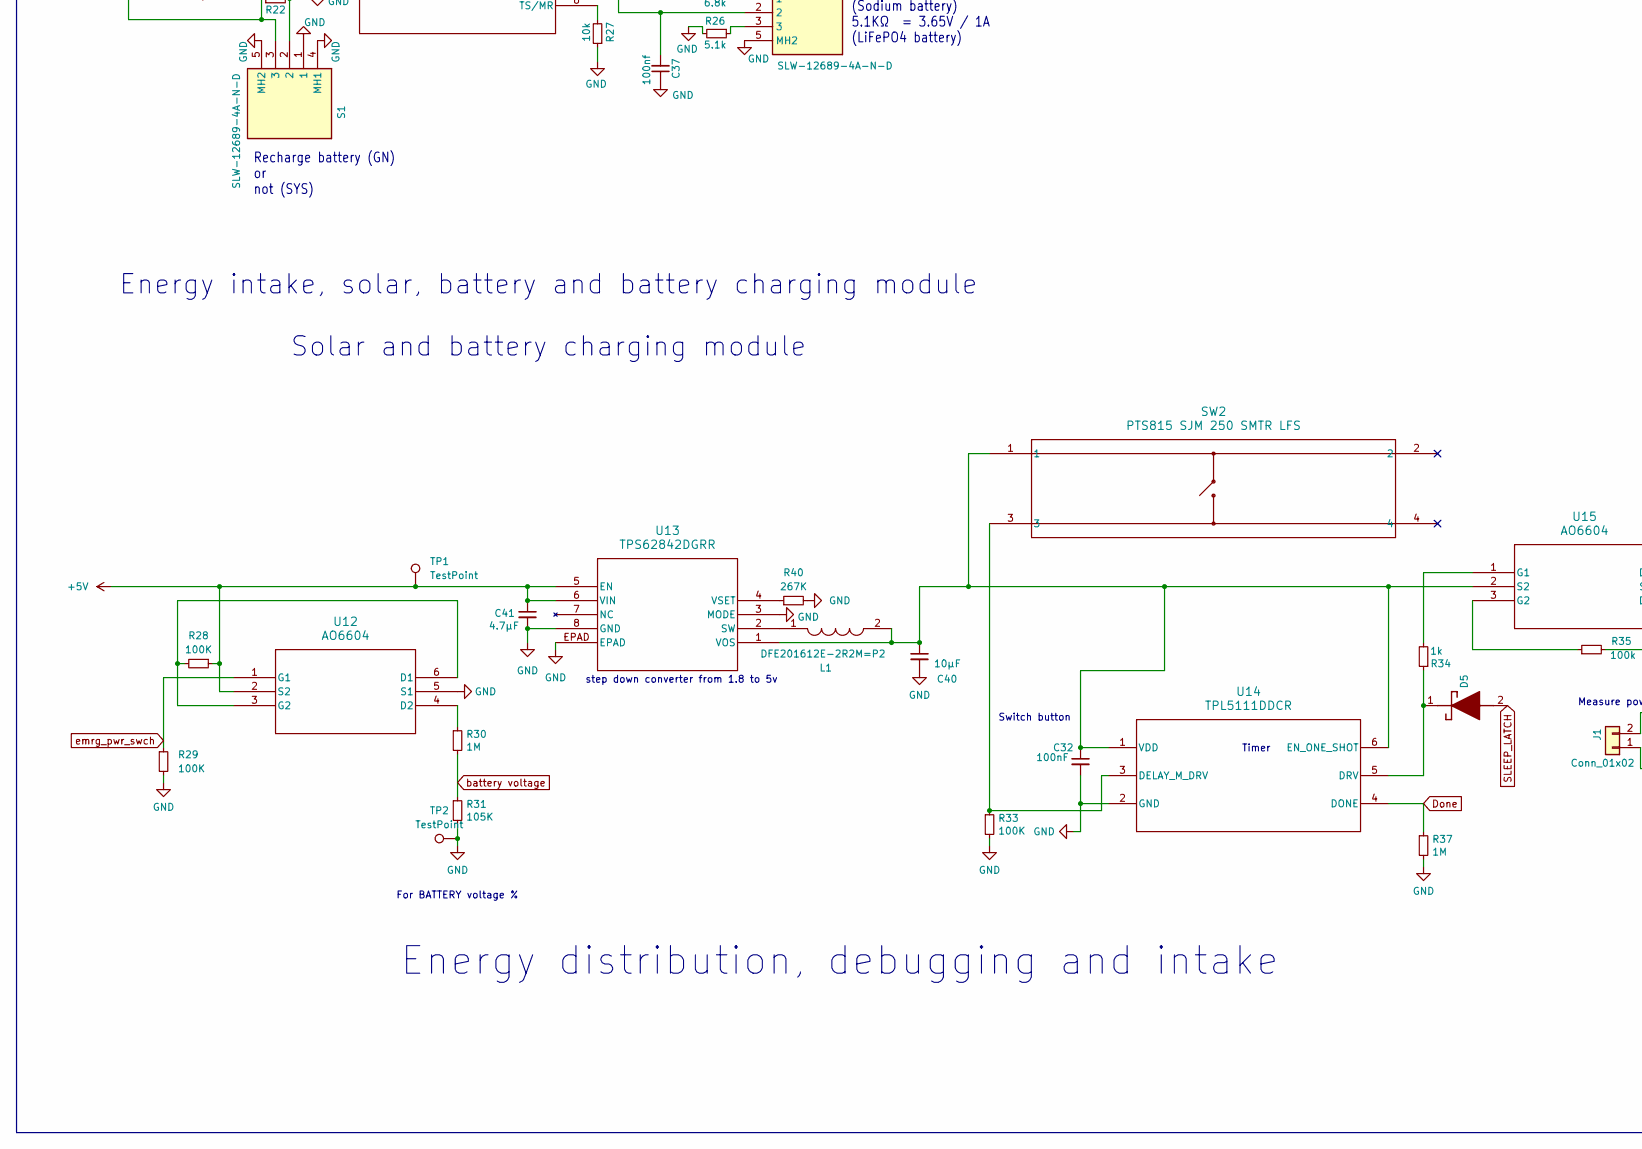
[picture p24: schematic SongBeam4.1.kicad_sch, Song Beam, part in row 2, column 1]

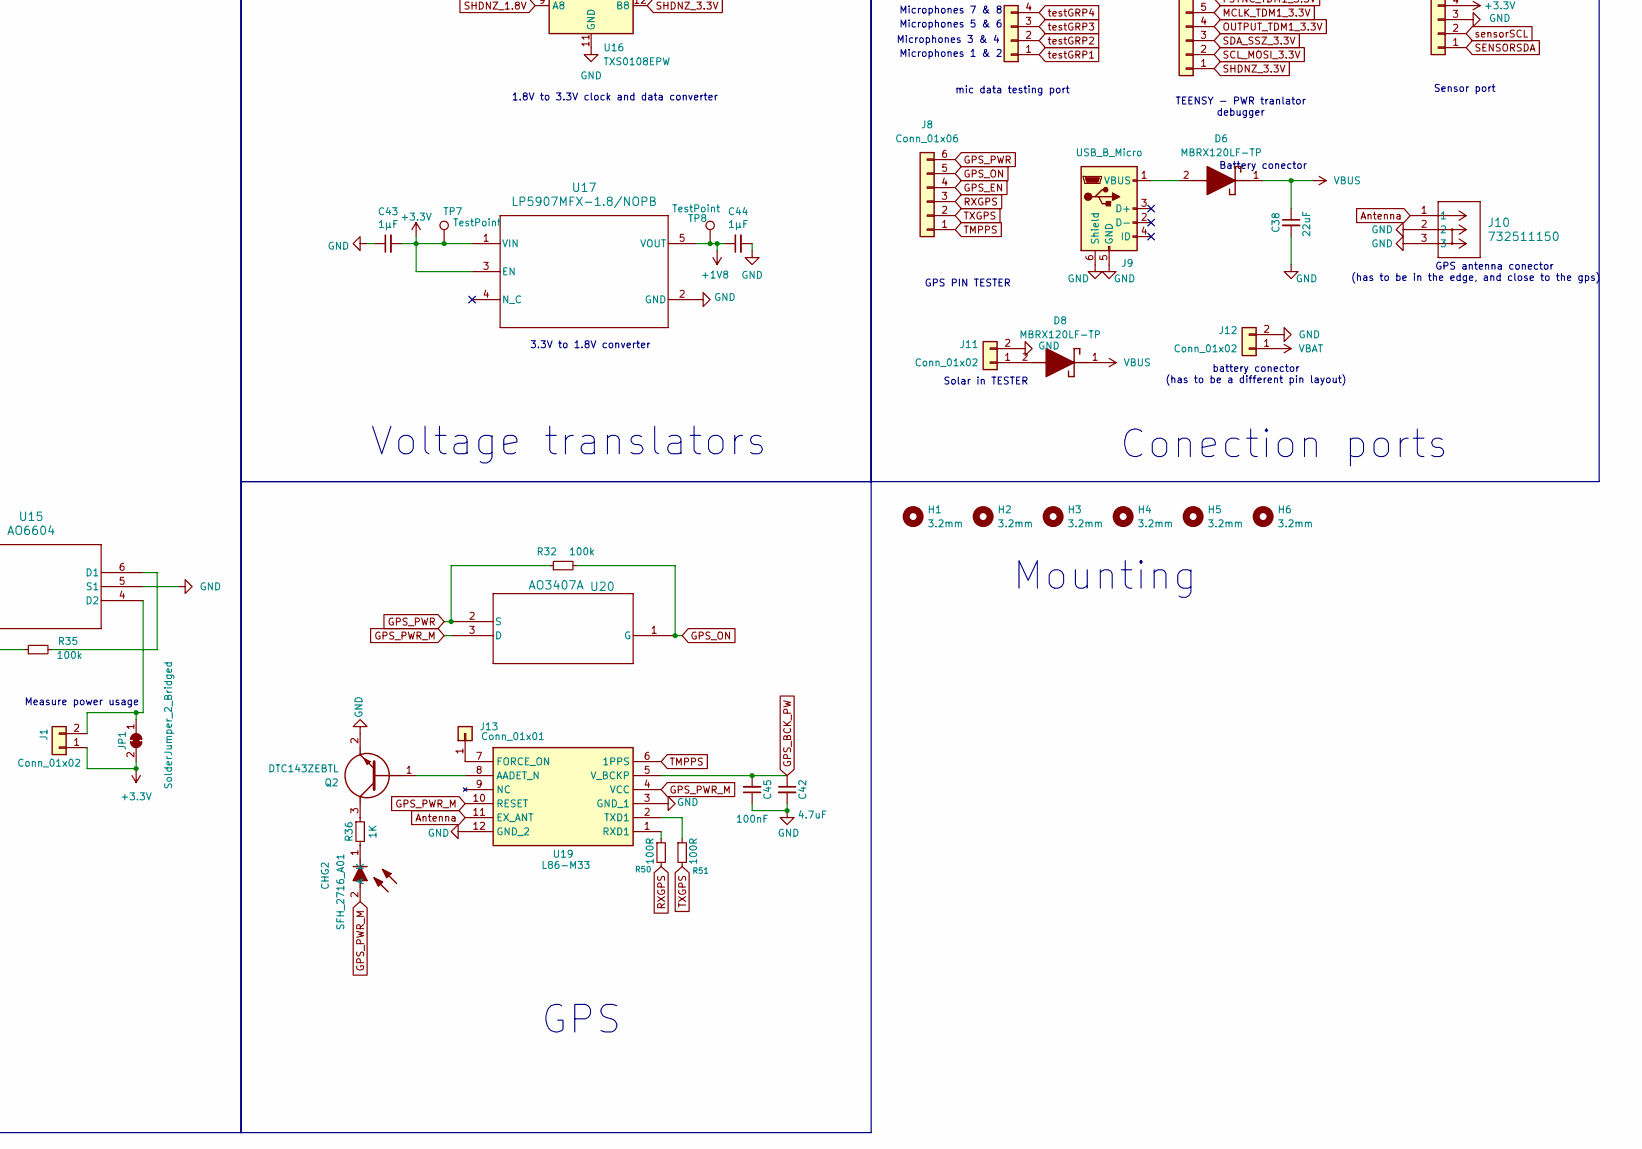
[picture p25: schematic SongBeam4.1.kicad_sch, Song Beam, part in row 2, column 2]

Parts:
BAT1: 3034; 79523211; Manufacturer_Part_Number 3034; Mouser Part Number 534-3034
C1, C3, C5, C7, C9, C11, C13, C15, C18, C21, C24, C25, C32, C45: 100nF; C_0805_2012Metric
C2, C4, C6, C8, C10, C12, C14, C16: 47pF; C_0805_2012Metric
C17, C19, C20: 1uF; C_0805_2012Metric
C22, C23, C26: 10uF; C_0805_2012Metric
C27, C28, C29, C38: 22uF; C_0805_2012Metric
C34, C35: 0.1uF; C_0805_2012Metric
C37: 100nf; C_0805_2012Metric
C40: 10µF; C_0805_2012Metric
C41: 4.7µF; C_0805_2012Metric
C42: 4.7uF; C_0805_2012Metric
C43, C44: 1µF; C_0805_2012Metric
CHG1, CHG2: SFH_2716_A01; LEDC2012X100N; Mouser Part Number 720-SFH2716A01A0954
D1: APHF1608LSEEQBDZGKC; LED-APA102-2020; PARTREV V.3B; Mouser Part Number 604-APHF1608LQBDZGKC
D2: BAT54AW; SOT-323_SC-70
D5, D6, D8: MBRX120LF-TP; SOD3716X135N; Mouser Part Number 833-MBRX120LF-TP
F1, F3: Polyfuse; MINISMDC050F2
FAULT1: SFH_2716_A01; LEDC2012X100N; Mouser Part Number 720-SFH2716A01A0954
H1, H2, H3, H4, H5, H6: 3.2mm; MountingHole_3.2mm_M3_ISO14580
J1, J11, J12: Conn_01x02; PinHeader_1x02_P1.00mm_Vertical
J2, J3: RJ45; CONN_RJHSE-3380_AMP
J4, J6: Conn_01x07; PinHeader_1x07_P1.00mm_Vertical
J5, J7: Conn_01x04; PinHeader_1x04_P1.00mm_Vertical
J8: Conn_01x06; PinHeader_1x06_P1.00mm_Vertical
J9: USB_B_Micro; 101181920002LF
J10: 732511150; CONN_73251-1150_MOL
J13: Conn_01x01; PinHeader_1x01_P1.00mm_Vertical
JP1: SolderJumper_2_Bridged; SolderJumper-2_P1.3mm_Bridged_RoundedPad1.0x1.5mm
L1: DFE201612E-2R2M=P2; 1286ASH1R0MP2; Manufacturer_Part_Number DFE201612E-2R2M=P2; Mouser Part Number 81-DFE201612E-2R2MP2
Q2: DTC143ZEBTL; SOTFL50P160X85-3N; Mouser Part Number 755-DTC143ZEBTL
R1, R3, R5, R7, R9, R11, R13, R15, R17, R50, R51: 100R; R_0805_2012Metric
R2, R4, R6, R8, R10, R12, R14, R16, R22, R28, R29, R33: 100K; R_0805_2012Metric
R18, R19: 330R; R_0805_2012Metric
R20: 750R; R_0805_2012Metric
R21, R23, R36: 1K; R_0805_2012Metric
R24: 300R; R_0805_2012Metric
R25: 6.8k; R_0805_2012Metric
R26: 5.1k; R_0805_2012Metric
R27: 10k; R_0805_2012Metric
R30, R37: 1M; R_0805_2012Metric
R31: 105K; R_0805_2012Metric
R32, R35: 100k; R_0805_2012Metric
R34: 1k; R_0805_2012Metric
R38: 10K; R_0805_2012Metric
R40: 267K; R_0805_2012Metric
S1, S2: SLW-12689-4A-N-D; SLW126894AND; Mouser Part Number 179-SLW126894AND
SW2, SW3: PTS815 SJM 250 SMTR LFS; SW4_PTS815 SJM 250 SMTR LFS_CNK
TP1, TP2, TP7, TP8: TestPoint; TestPoint_Pad_D1.0mm
U1, U2, U3, U4, U5, U6, U7, U8: IM66D132H; IFX-PG-TLGA-5N-9-V
U9: PCMD3180IRTWR
U10: Teensy4.1; Teensy41
U11: BQ25185DLHR
U12, U15: AO6604
U13: TPS62842DGRR
U14: TPL5111DDCR; SOT95P280X110-6N
U16: TXS0108EPW; TSSOP-20_4.4x6.5mm_P0.65mm
U17: LP5907MFX-1.8/NOPB; DBV0005A_N
U19: L86-M33; L80-M39; Mouser Part Number 277-L86-M33
U20: AO3407A; SOT-23-3L_AOS

Connections:
+1V8: C1.1, C3.1, C5.1, C7.1, C9.1, C11.1, C13.1, C15.1, C25.1, C26.2, C34.1, C44.1, R38.1, TP8.1, U1.2 (LR), U1.5 (VDD), U2.5 (VDD), U3.2 (LR), U3.5 (VDD), U4.5 (VDD), U5.2 (LR), U5.5 (VDD), U6.5 (VDD), U7.2 (LR), U7.5 (VDD), U8.5 (VDD), U9.19 (IOVDD), U16.2 (VCCA), U16.10 (OE), U17.5 (VOUT)
+3.3V: C17.1, C18.2, C35.1, C43.2, J1.1, J2.8, J7.4, JP1.2 (B), TP7.1, U9.1 (AVDD), U10.48 (VIN), U16.19 (VCCB), U17.1 (VIN), U17.3 (EN)
+5V: C28.1, C41.1, CHG1.2 (A), FAULT1.2 (A), R22.1, R28.1, S1.3, TP1.1, U11.1 (SYS), U12.2 (S2), U13.5 (EN), U13.6 (VIN)
Antenna: J10.1, U19.11 (EX_ANT)
BCLK_TDM1_1.8V: J4.7, U9.22 (BCLK), U16.1 (A1)
BCLK_TDM1_3.3V: J6.7, U10.21 (29_TX7), U16.20 (B1)
BCLK_TDM2_3.3V: J3.8, U10.4 (2_OUT2)
Done: R37.1, U10.24 (32_OUT1B), U14.4 (DONE)
FSYNC_1.8V: U9.23 (FSYNC)
FSYNC_TDM1_1.8V: J4.6, U16.3 (A2)
FSYNC_TDM1_3.3V: J6.6, U10.20 (28_RX7), U16.18 (B2)
FSYNC_TDM2_3.3V: J2.2, U10.3 (1_TX1_CTX2_MISO1)
GND: BAT1.3 (NEG._CONTACT_PAD_(GND)), C1.2, C2.2, C3.2, C4.2, C5.2, C6.2, C7.2, C8.2, C9.2, C10.2, C11.2, C12.2, C13.2, C14.2, C15.2, C16.2, C17.2, C18.1, C19.2, C20.2, C21.1, C22.2, C23.1, C24.2, C25.2, C26.1, C27.1, C28.2, C29.1, C32.2, C34.2, C35.2, C37.1, C38.2, C40.2, C41.2, C42.2, C43.1, C44.2, C45.1, J2.1, J2.3, J2.5, J2.7, J3.3, J3.5, J3.7, J7.3, J9.5 (GND), J9.6 (Shield), J10.2, J10.3, J11.2, J12.2, Q2.2 (E), R2.1, R4.2, R6.2, R8.2, R10.2, R12.2, R14.2, R16.2, R24.2, R25.2, R26.2, R27.1, R29.2, R31.2, R33.2, R37.2, R38.2, R40.2, S1.1, S1.4 (MH1), S1.5 (MH2), S2.4 (MH1), S2.5 (MH2), SW3.3, TP2.1, U1.3 (GND), U2.2 (LR), U2.3 (GND), U3.3 (GND), U4.2 (LR), U4.3 (GND), U5.3 (GND), U6.2 (LR), U6.3 (GND), U7.3 (GND), U8.2 (LR), U8.3 (GND), U9.4 (AVSS), U9.15 (ADDR1_MISO), U9.16 (ADDR0_SCLK), U9.25 (VSS), U10.1 (GND), U10.34 (GND), U10.47 (GND), U10.52 (GND), U11.5 (GND), U11.11 (EPAD), U12.5 (S1), U13.3 (MODE), U13.8 (GND), U13.EPAD, U14.2 (GND), U15.5 (S1), U16.11 (GND), U17.2 (GND), U19.3 (GND_1), U19.12 (GND_2)
GPS_BCK_PW: C42.1, C45.2, D2.1, U19.5 (V_BCKP)
GPS_EN: J8.4
GPS_ON: J8.5, R32.2, U10.31 (39_MISO1_OUT1A), U20.1 (G)
GPS_PWR: J8.6, R32.1, U10.15 (3V3), U20.2 (S)
GPS_PWR_M: CHG2.2 (A), U19.4 (VCC), U19.10 (RESET), U20.3 (D)
MCLK_TDM1_1.8V: J4.5, U9.20 (GPIO1), U16.4 (A3)
MCLK_TDM1_3.3V: J6.5, U10.23 (31_CTX3), U16.17 (B3)
MCLK_TDM2_3.3V: J3.6, U10.33 (41_A17)
unnamed: BAT1.1, BAT1.2, D2.3
unnamed: CHG1.1 (K), R21.2
unnamed: CHG2.1 (K), R36.2
unnamed: D1.1, U10.46 (3V3)
unnamed: D1.2, R20.1
unnamed: D1.3, R19.1
unnamed: D1.4, R18.1
unnamed: D5.1 (K), R34.1, U14.5 (DRV)
unnamed: D6.2 (A), J9.1 (VBUS)
unnamed: D8.2 (A), J11.1
unnamed: FAULT1.1 (K), R23.1
unnamed: J1.2, JP1.1 (A), U15.4 (D2)
unnamed: J13.1, U19.7 (FORCE_ON)
unnamed: Q2.1 (B), U19.8 (AADET_N)
unnamed: Q2.3 (C), R36.1
unnamed: R25.1, S2.1
unnamed: R26.1, S2.3
unnamed: C21.2, C22.1, U9.2 (AREG)
unnamed: C23.2, C24.1, U9.24 (DREG)
unnamed: C20.1, U9.5 (MICBIAS)
unnamed: R17.2, U9.21 (SDOUT)
unnamed: C19.1, U9.3 (VREF)
unnamed: R20.2, U10.36 (14_A0_TX3_SPDIF_OUT)
unnamed: R19.2, U10.37 (15_A1_RX3_SPDIF_IN)
unnamed: R18.2, U10.38 (16_A2_RX4_SCL1)
unnamed: SW3.1, U10.45 (23_A9_CRX1_MCLK1)
unnamed: D2.2, U10.50 (VBAT)
unnamed: C27.2, F1.1, U11.2 (BAT)
unnamed: C37.2, S2.2, U11.7 (ILIM/VSET)
unnamed: C29.2, F3.1, U11.10 (IN)
unnamed: R24.1, U11.8 (ISET)
unnamed: R23.2, U11.9 (STAT1)
unnamed: R21.1, U11.3 (STAT2)
unnamed: R27.2, U11.6 (TS/MR)
unnamed: R22.2, S1.2, U11.4 (/CE)
unnamed: R28.2, U12.3 (G2), U12.6 (D1)
unnamed: R30.1, U12.4 (D2)
unnamed: L1.1, U13.2 (SW)
unnamed: C32.1, C40.1, L1.2, SW2.1, U13.1 (VOS), U14.1 (VDD), U14.6 (EN_ONE_SHOT), U15.2 (S2)
unnamed: R40.1, U13.4 (VSET)
unnamed: R33.1, SW2.3, U14.3 (DELAY_M_DRV)
unnamed: R35.2, U15.6 (D1)
unnamed: R34.2, U15.1 (G1)
unnamed: R35.1, U15.3 (G2)
unnamed: R50.1, U19.1 (RXD1)
unnamed: R51.1, U19.2 (TXD1)
OUTPUT_TDM1_1.8V: J4.4, R17.1, U16.6 (A5)
OUTPUT_TDM1_3.3V: J6.4, U10.8 (6_OUT1D), U16.15 (B5)
OUTPUT_TDM2_3.3V: J3.4, U10.5 (3_LRCLK2)
RXGPS: J8.3, R50.2, U10.26 (34_RX8)
SCL_MOSI_1.8V: J4.2, U9.17 (SCL_MOSI), U16.8 (A7)
SCL_MOSI_3.3V: J2.4, J6.2, U10.41 (19_A5_SCL), U16.13 (B7)
SDA_SSZ_1.8V: J4.3, U9.18 (SDA_SSZ), U16.7 (A6)
SDA_SSZ_3.3V: J6.3, U10.40 (18_A4_SDA), U16.14 (B6)
SENSORSDA: J7.1, U10.17 (25_A11_RX6_SDA2)
SHDNZ_1.8V: J4.1, U9.14 (SHDNZ), U16.9 (A8)
SHDNZ_3.3V: J2.6, J6.1, U10.39 (17_A3_TX4_SDA1), U16.12 (B8)
SLEEP_LATCH: D5.2 (A), U10.22 (30_CRX3)
TMPPS: J8.1, U10.7 (5_IN2), U19.6 (1PPS)
TXGPS: J8.2, R51.2, U10.27 (35_TX8)
VBAT: F1.2, J12.1
VBUS: C38.1, D6.1 (K), D8.1 (K), F3.2
battery voltage: R30.2, R31.1, U10.18 (26_A12_MOSI1)
emrg_pwr_swch: R29.1, U10.11 (9_OUT1C), U12.1 (G1)
micGRP_1out_1.8V: C2.1, C4.1, R1.2, R2.2, R3.2, R4.1, U9.6 (PDMDIN1_GPI1)
micGRP_2IN_1.8V: U3.4 (CLK), U4.4 (CLK), U9.9 (PDMLK2_GPO2)
micGRP_2out_1.8V: C6.1, C8.1, R5.2, R6.1, R7.2, R8.1, U9.8 (PDMDIN2_GPI2)
micGRP_3IN_1.8V: U5.4 (CLK), U6.4 (CLK), U9.11 (PDMCLK3_GPO3)
micGRP_3out_1.8V: C10.1, C12.1, R9.2, R10.1, R11.2, R12.1, U9.10 (PDMDIN3_GPI3)
micGRP_4IN_1.8V: U7.4 (CLK), U8.4 (CLK), U9.13 (PDMCLK4_GPO4)
micGRP_4out_1.8V: C14.1, C16.1, R13.1, R14.1, R15.1, R16.1, U9.12 (PDMDIN4_GPI4)
micgrp_1IN_1.8V: U1.4 (CLK), U2.4 (CLK), U9.7 (PDMLK1_GPO1)
sensorSCL: J7.2, U10.16 (24_A10_TX6_SCL2)
testGRP1: J5.1, R1.1, R3.1, U1.1 (DATA), U2.1 (DATA)
testGRP2: J5.2, R5.1, R7.1, U3.1 (DATA), U4.1 (DATA)
testGRP3: J5.3, R9.1, R11.1, U5.1 (DATA), U6.1 (DATA)
testGRP4: J5.4, R13.2, R15.2, U7.1 (DATA), U8.1 (DATA)

Notes on the sheet:
PCMD3180 - PWR translator debugger
Sensor port
battery conector (has to be a different pin layout)
Microphones modules
Switch button
Recharge battery (GN) or not (SYS)
Solar in TESTER
step down converter from 1.8 to 5v
Microphones 7 & 8
Energy intake, solar, battery and battery charging module Solar and battery charging module
GPS PIN TESTER
6.8KΩ = 4.05V / 1A (Sodium battery) 5.1KΩ = 3.65V / 1A (LiFePO4 battery)
Daughter board connection 1
Conection ports
MIC 6
MIC 4
To run LED test (battery % & SD card %)
3.3V to 1.8V converter
MIC 7
analog ground
300Ω = 1000mA
Daughter board connection 2
Mounting
Voltage translators
Battery conector
MIC 3
MIC 8
MIC 5
Timer
Microphones 1 & 2
Microphones 5 & 6
1.8V to 3.3V clock and data converter
Microphones 3 & 4
Microcontrollers
Energy distribution, debugging and intake
daisy-chaining ->
For BATTERY voltage %
MIC 2
MIC 1
CODEC 2
Mic checker
TEENSY - PWR tranlator debugger
mic data testing port
GPS antenna conector (has to be in the edge, and close to the gps)
Measure power usage
GPS

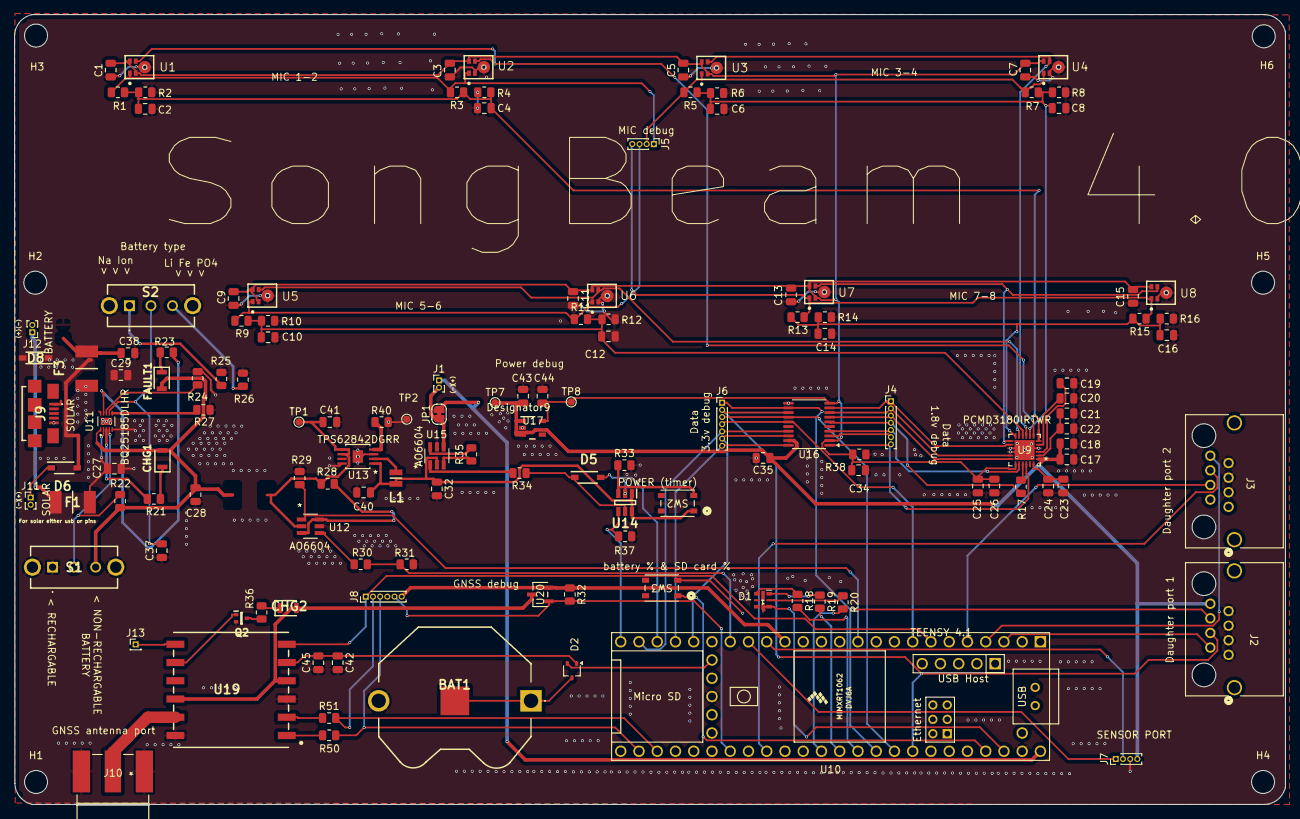
[picture p26: board SongBeam4.1.kicad_pcb from above]

Board: 2 copper layers, 176.9 x 110.0 mm, 141 parts (0 on the bottom side), 94 nets.
