MarcosQOliva/SongBeam/modulesTAD/ADAFRUIT bq25185/Adafruit bq25185 Breakout.kicad_pcb

## KiCad design modulesTAD/ADAFRUIT bq25185/Adafruit bq25185 Breakout.kicad_pcb (2026-01-21)

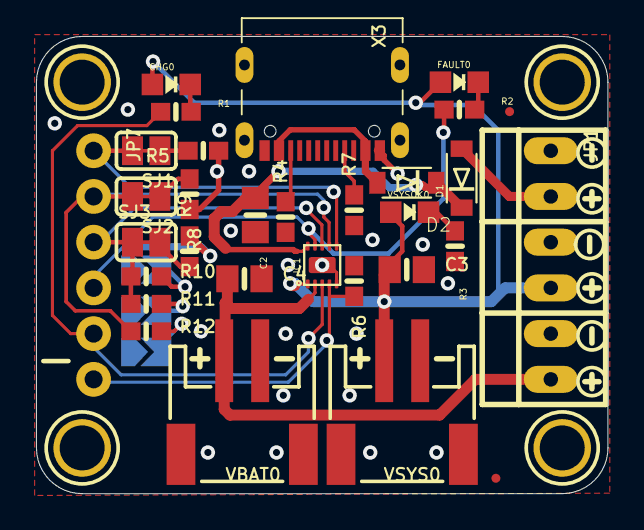
[picture p29: board Adafruit bq25185 Breakout.kicad_pcb from above]

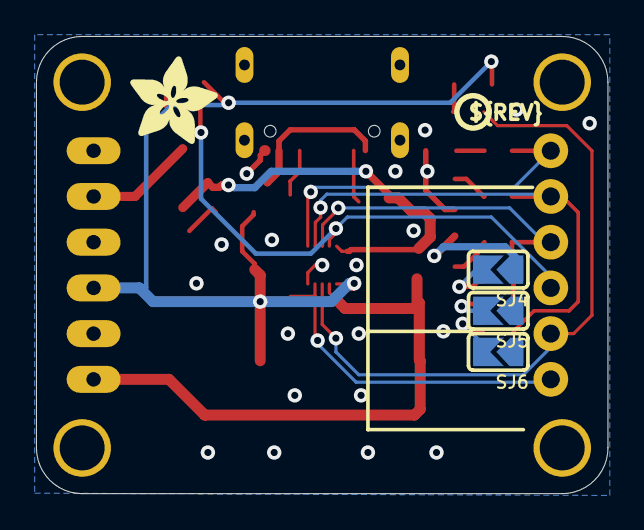
[picture p30: board Adafruit bq25185 Breakout.kicad_pcb from below]

Board: 2 copper layers, 31.8 x 25.4 mm, 69 parts (13 on the bottom side), 23 nets.

Parts:
C2, C3, C4: 22uF; 0805-NO
CHG0: ORANGE; CHIPLED_0805_NOOUTLINE
D1, D2: MBRX120; SOD-123FL
FAULT0: RED; CHIPLED_0805_NOOUTLINE
IC1: BQ25185; WSON10
JP1: 1X06_OVALWAVE
JP2, JP4: FIDUCIAL1.5X3; FIDUCIAL_0.5MM
JP7: 1X06_ROUND_76
PLABEL0: PLABEL0
PLABEL1: PLABEL1
PLABEL2: PLABEL2
PLABEL3: PLABEL3
PLABEL4: PLABEL4
PLABEL5: PLABEL5
PLABEL6: PLABEL6
PLABEL7: PLABEL7
PLABEL8: PLABEL8
PLABEL9: PLABEL9
PLABEL10: PLABEL10
PLABEL11: PLABEL11
PLABEL12: PLABEL12
PLABEL13: PLABEL13
PLABEL14: PLABEL14
PLABEL15: PLABEL15
PLABEL16: PLABEL16
PLABEL17: PLABEL17
PLABEL18: PLABEL18
PLABEL19: PLABEL19
PLABEL20: PLABEL20
PLABEL21: PLABEL21
PLABEL22: PLABEL22
R1, R2, R3: 1K; 0603-NO
R4, R7, R12: 5.1K; 0603-NO
R5, R6: 10K; 0603-NO
R8: 13K; 0603-NO
R9: 600; 0603-NO
R10: 300; 0603-NO
R11: 1200; 0603-NO
SJ1, SJ2, SJ3: SOLDERJUMPER_CLOSEDWIRE
SJ4, SJ5, SJ6: SOLDERJUMPER_ARROW_NOPASTE
U$11, U$16, U$18, U$19: MOUNTINGHOLE2.5; MOUNTINGHOLE_2.5_PLATED
U$23, U$27, U$28: SYMBOL_PLUS
U$24, U$25, U$26: SYMBOL_MINUS
U$46: ADAFRUIT_5MM
U$47: PCBFEAT-REV-040
VBAT0: JST2PH; JSTPH2_BATT
VSYS0: JST2PH; JSTPH2_BATT
VSYSOK0: GREEN; CHIPLED_0805_NOOUTLINE
X3: USBC; USB_C_CUSB31-CFM2AX-01-X

Connections:
5.0V: C3.1, CHG0.A, FAULT0.A, IC1.1, JP1.4, VSYS0.2, VSYSOK0.A
/CE: IC1.4, JP7.6, R6.2
GND: C2.2, C3.2, C4.2, IC1.5, IC1.PAD, JP1.1, JP1.3, JP1.5, R3.2, R4.1, R5.1, R6.1, R7.1, R8.2, R9.2, SJ4.1, SJ5.1, SJ6.1, VBAT0.1, VBAT0.NC1, VBAT0.NC2, VSYS0.1, VSYS0.NC1, VSYS0.NC2, X3.A1B12, X3.B1A12
ISET: IC1.8, JP7.3, R10.1, R11.1, SJ3.1
unnamed: CHG0.C, R1.2
unnamed: FAULT0.C, R2.2
unnamed: R8.1, SJ2.1
unnamed: R4.2, X3.B5
unnamed: R5.2, SJ1.1
unnamed: R7.2, X3.A5
unnamed: R9.1, SJ3.2
unnamed: R10.2, SJ4.2
unnamed: R11.2, SJ5.2
unnamed: R12.2, SJ6.2
unnamed: D1.A, JP1.2
unnamed: R3.1, VSYSOK0.C
STAT1: IC1.9, JP7.4, R2.1
STAT2: IC1.3, JP7.5, R1.1
THERM: IC1.6, JP7.1, SJ1.2
USB: D2.A, X3.A4B9, X3.B4A9
VBAT: C4.1, IC1.2, JP1.6, VBAT0.2
VBUS: C2.1, D1.C, D2.C, IC1.10
VSET: IC1.7, JP7.2, R12.1, SJ2.2
