MarcosQOliva/SongBeam/(commit log)

2026-01-19 daughterBRD-UPDATE main BRD
    added a full desing for daugther BRD, has a new microcontroller for 8 mics with TDM output
    Start changes in the 4.0 version of the Soundbeam, making combatible with the daughter board
    [Adafruit bq25185 Breakout.kicad_pcb, Adafruit bq25185 Breakout.kicad_sch, SongBeam3.1.kicad_sch, SongBeam4.0.kicad_pcb, SongBeam4.0.kicad_sch, Untitled.kicad_pcb, Untitled.kicad_sch, sisterboard_A.kicad_pcb]
2026-01-21 tweaks in daugtherboard and develop in the main 4.0 board
    changed voltage, added voltage translators and swiched from ethernet to HDMI
    [Adafruit bq25185 Breakout.kicad_pcb, Adafruit bq25185 Breakout.kicad_sch, SongBeam3.1.kicad_pcb, SongBeam3.1.kicad_sch, SongBeam3.1.sch, SongBeam3.1_old2.csv, SongBeam3.1x_old3.csv, SongBeam4.0.kicad_pcb]
2026-01-22 Small tweaks, implementing the power modules
    [SongBeam4.0.kicad_sch, sisterboard_A.kicad_sch]
2026-01-26 small tweaks
    [SongBeam4.0.kicad_sch]
2026-01-29 tweaks better
    [SongBeam4.0.kicad_sch]
2026-02-03 backup switch to cat6
    [SongBeam4.0.kicad_sch]
2026-02-07 V1 BRD_4.0
    finish the schematics
    [SongBeam4.0.kicad_sch]
2026-02-10 pcb sketch v1
    [SongBeam4.0.kicad_pcb, SongBeam4.0.kicad_sch]
2026-02-11 pcb savepoint
    [SongBeam4.0.kicad_pcb, SongBeam4.0.kicad_sch]
2026-02-11 Tracing V1 SB4.0
    [SongBeam4.0.kicad_pcb]
2026-02-12 Pcb bugfixxing
    [SongBeam4.0.kicad_pcb, SongBeam4.0.kicad_sch]
2026-02-26 Layout updates
    [GJM1555C1H470JB01D.step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]
2026-02-26 makeover director + pcb layout finish
    [BOM SB4.csv, SongBeam3.1.kicad_pcb, SongBeam3.1.kicad_sch, SongBeam3.1.sch, SongBeam3.1_old2.csv, SongBeam3.1x_old3.csv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]
2026-02-26 tweak bom
    [daugtherboard_1.1.csv]
2026-03-03 bom main board update
    [BOM SB4.csv, SongBeam4.0.kicad_sch]
2026-03-03 change resistor 300 to 300R
    [SongBeam4.0.kicad_pcb]
2026-03-03 bom fix
    [BOM SB4.csv]
2026-03-03 fixed weird bug that keeps deleting microphone
    [SongBeam4.0.kicad_pcb]
2026-03-03 fixed the bom too from the bug
    [BOM SB4.csv]
2026-03-04 added a version for manual routing
    [BOM SB4.csv, SongBeam4.0.kicad_sch, SongBeam4.0_BRKOUT.kicad_pcb, SongBeam4.1.kicad_pcb, SongBeam4.1.kicad_sch]
2026-04-28 ethernet port updated, fixed flaws 1.1 DB
    [BOM SB4.csv, RJHSE3380A1.stp, SongBeam4.1.kicad_sch, daugtherboard_1.1.csv, daugtherboard_1.2.kicad_pcb, daugtherboard_1.2.kicad_sch]
2026-04-28 implemented ethernet port pcb R/a
    [SongBeam4.1.kicad_sch, daugtherboard_1.2.kicad_pcb, daugtherboard_1.2.kicad_sch]
2026-11-06 fast track changes to 2 board solution
2026-11-07 v1 schematics for the main board and hat
    First revision of the schematics
2026-11-11 pcb mic layout (tracing pending)
2026-11-11 one trace extra
2026-11-11 first trace
