MarcosQOliva/SongBeam/(notices)

Notices in the files:
Hardware/SongBeam3.1/SongBeam3.1.kicad_pcb:
CC BY 4.0
parts and their libraries:
Copyright 2016 Accelerated Designs. All rights reserved.
